BLogic-Microelectronic/BLogic-MCU/asic/reports/routing/wire_lengths.csv

net | length_um
i_soc.i_cpu.core_i.id_stage_i.regfile_addr_rc_id\[1\] | 7.905335mm
i_soc.i_cpu.core_i.id_stage_i.regfile_addr_rc_id\[0\] | 6.897295mm
i_soc.i_cpu.core_i.id_stage_i.regfile_addr_rc_id\[2\] | 4.46121mm
net1894 | 4.13363mm
net1641 | 4.11913mm
net1624 | 3.90591mm
net1005 | 3.87298mm
net1895 | 3.86943mm
net987 | 3.84854mm
net1642 | 3.7976mm
i_soc.i_cpu.core_i.id_stage_i.register_file_i._1001_ | 3.71167mm
net641 | 3.5976mm
net988 | 3.57505mm
net1356 | 3.54232mm
net1006 | 3.51843mm
net1362 | 3.41506mm
net1023 | 3.400835mm
net1317 | 3.39428mm
net1623 | 3.39394mm
net1299 | 3.391395mm
net1335 | 3.388515mm
net1357 | 3.37431mm
net781 | 3.34893mm
net780 | 3.33756mm
net1352 | 3.29609mm
net770 | 3.29593mm
net1300 | 3.26414mm
net1024 | 3.26218mm
net1342 | 3.2589mm
net790 | 3.25837mm
net775 | 3.248905mm
net1318 | 3.246175mm
net1347 | 3.24044mm
net1336 | 3.23486mm
net773 | 3.22972mm
net776 | 3.20083mm
net1337 | 3.18531mm
net795 | 3.17406mm
net800 | 3.15847mm
net771 | 3.15771mm
net1372 | 3.1337mm
net772 | 3.07681mm
net632 | 3.06338mm
i_soc.data_sram_bus.w_data\[11\] | 3.05232mm
net1377 | 3.0516mm
net785 | 3.05074mm
net1345 | 3.04885mm
i_soc.data_sram_bus.w_data\[15\] | 3.04538mm
i_soc.data_sram_bus.w_data\[10\] | 3.03835mm
net805 | 3.03568mm
net1387 | 3.03007mm
net1367 | 3.02305mm
i_soc.i_crossbar.instr_sram_mst.w_data\[23\] | 3.01788mm
net637 | 3.01578mm
i_soc.data_sram_bus.w_data\[8\] | 2.99364mm
net778 | 2.97687mm
net788 | 2.969405mm
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
net704 | 930.14µm
i_soc.i_instr_sram.u_sram.dout\[25\] | 930.01µm
i_soc.i_ai_accel._04530_ | 929.68µm
net4081 | 928.73µm
i_soc.cpu_data_bus.w_data\[23\] | 928.375µm
i_soc.i_axi_lite_bridge.m_araddr\[0\] | 927.02µm
net4087 | 927.01µm
i_soc.i_cpu.core_i.cs_registers_i._0949_ | 926.265µm
i_soc.ai_sram_bus.w_data\[17\] | 925.92µm
i_soc.i_ai_accel.state\[20\] | 924.76µm
i_soc.i_ai_sram.u_sram._315_ | 924.72µm
i_soc.i_instr_sram.u_sram.dout\[27\] | 924.14µm
net4102 | 922.7µm
i_soc.i_instr_sram.u_sram.dout\[6\] | 921.46µm
net4116 | 920.995µm
i_soc.i_data_sram.u_sram.dout\[39\] | 920.64µm
i_soc.cpu_data_bus.w_data\[16\] | 919.82µm
i_soc.cpu_data_bus.aw_addr\[11\] | 919.805µm
net4080 | 916.845µm
net687 | 915.98µm
i_soc.cpu_data_bus.w_data\[22\] | 915.12µm
i_soc.cpu_data_bus.w_data\[21\] | 913.74µm
net715 | 913.51µm
i_soc.i_uart_0._258_ | 912.595µm
net1212 | 911.97µm
i_soc.cpu_data_bus.w_data\[20\] | 911.61µm
i_soc.i_cpu.core_i.ex_stage_i.mult_i.op_b_i\[12\] | 911.13µm
i_soc.ai_sram_bus.w_data\[27\] | 910.22µm
i_soc.i_ai_sram.u_sram.gen_bank\[3\].csb0 | 910.03µm
i_soc.i_cpu.core_i.ex_stage_i.mult_i.op_b_i\[17\] | 909.98µm
net7548 | 909.22µm
i_soc.i_data_sram.u_sram.dout\[38\] | 908.07µm
i_soc.i_instr_sram.u_sram.gen_bank\[0\].csb1 | 907.24µm
i_soc.i_crossbar.instr_sram_mst.r_data\[8\] | 906.56µm
i_soc.i_ai_sram.u_sram._325_ | 905.345µm
i_soc.i_cpu.core_i.ex_stage_i.mult_i.op_b_i\[16\] | 904.44µm
net8659 | 904.295µm
i_soc.i_axi_lite_bridge.m_wdata\[14\] | 904.23µm
i_soc.cpu_data_bus.aw_addr\[12\] | 904.12µm
i_soc.cpu_data_bus.w_strb\[3\] | 903.97µm
i_soc.i_axi_lite_bridge.m_araddr\[1\] | 903.59µm
net1934 | 901.7µm
i_soc.i_qspi._07408_ | 900.295µm
i_soc.i_ai_accel._04545_ | 899.96µm
i_soc.i_crossbar.instr_sram_mst.r_data\[16\] | 899.8µm
net8688 | 899.35µm
i_soc.i_qspi._07425_ | 899.145µm
i_soc.i_instr_sram.u_sram.dout\[5\] | 897.23µm
i_soc.i_cpu.core_i.cs_registers_i.csr_save_ex_i | 894.42µm
net8658 | 894.415µm
i_soc.i_ai_sram.u_sram._035_ | 893.8µm
i_soc.i_cpu.core_i.ex_stage_i.mult_i.op_b_i\[13\] | 893.045µm
net4096 | 892.92µm
i_soc.i_instr_sram.u_sram.dout\[26\] | 892.64µm
i_soc.i_ai_sram.u_sram.gen_bank\[11\].csb0 | 892.33µm
net20330 | 891.83µm
net8717 | 891.805µm
i_soc.i_ai_accel.co_raddr\[9\] | 891.385µm
net4118 | 890.965µm
i_soc.i_ai_sram.u_sram._045_ | 890.88µm
net4078 | 890.44µm
i_soc.i_cpu.core_i.alu_operand_b_ex\[31\] | 889.115µm
i_soc.i_ai_accel._09532_ | 888.86µm
net8662 | 888.18µm
net4101 | 887.895µm
i_soc.i_cpu.core_i.ex_stage_i.mult_dot_op_c_i\[16\] | 887.695µm
i_soc.i_ai_sram.u_sram._335_ | 886.595µm
net20164 | 886.45µm
net8661 | 885.84µm
net4082 | 884.96µm
i_soc.i_cpu.core_i.ex_stage_i.mult_dot_op_c_i\[17\] | 883.74µm
i_soc.i_cpu.core_i.ex_stage_i.mult_dot_op_c_i\[5\] | 883.72µm
net4076 | 882.95µm
net3303 | 882.74µm
net3025 | 882.05µm
i_soc.i_cpu.core_i.ex_stage_i.mult_dot_op_c_i\[19\] | 881.21µm
net4110 | 881.16µm
i_soc.i_cpu.core_i.ex_stage_i.alu_i._1383_ | 881.09µm
clknet_6_4__leaf_clk_i_regs | 880.98µm
net8713 | 877.745µm
i_soc.i_ai_sram.u_sram._031_ | 877.66µm
net9087 | 877.1µm
i_soc.i_ai_accel._04533_ | 876.18µm
net4089 | 875.85µm
net3865 | 874.29µm
i_soc.i_ai_accel._09771_ | 874.14µm
i_soc.i_cpu.core_i.alu_operand_b_ex\[30\] | 872.05µm
i_soc.i_ai_accel.u_conv_out.gen_bank\[0\].csb1 | 870.31µm
i_soc.i_cpu.core_i.alu_operand_b_ex\[21\] | 870.05µm
i_soc.i_ai_sram.u_sram._018_ | 867.72µm
i_soc.i_cpu.core_i.ex_stage_i.mult_i.op_b_i\[14\] | 867.605µm
net8672 | 867.53µm
net4124 | 866.86µm
i_soc.i_cpu.core_i.ex_stage_i.mult_dot_op_c_i\[4\] | 866.685µm
i_soc.i_ai_sram.u_sram._016_ | 866.44µm
net8645 | 865.58µm
i_soc.i_ai_accel._04532_ | 865.49µm
i_soc.i_cpu.core_i.ex_stage_i.mult_i.op_b_i\[10\] | 864.83µm
net8644 | 864.2µm
i_soc.i_ai_accel._04650_ | 863.915µm
i_soc.i_cpu.core_i.ex_stage_i.mult_i.multicycle_o | 862.44µm
i_soc.i_crossbar.instr_sram_mst.r_data\[15\] | 861.34µm
i_soc.i_crossbar.instr_sram_mst.r_data\[13\] | 860µm
clknet_6_15__leaf_clk_i_regs | 859.805µm
net10603 | 859.7µm
net8646 | 858.03µm
i_soc.i_ai_sram.u_sram._332_ | 857.76µm
i_soc.i_qspi._07593_ | 857.44µm
net3971 | 854.88µm
net26 | 853.16µm
i_soc.i_cpu.core_i.ex_stage_i.mult_i.op_b_i\[15\] | 851.445µm
net8660 | 850.06µm
i_soc.i_ai_accel._05126_ | 849.675µm
net8674 | 849.46µm
i_soc.i_cpu.core_i.ex_stage_i.mult_dot_op_b_i\[26\] | 849.08µm
i_soc.i_ai_sram.u_sram._028_ | 847.96µm
net4077 | 847.425µm
i_soc.i_cpu.core_i.alu_operand_c_ex\[13\] | 846.745µm
i_soc.i_qspi.cmd_tx_data\[29\] | 846.51µm
i_soc.i_cpu.core_i.alu_operand_b_ex\[3\] | 846.435µm
i_soc.i_axi_lite_bridge.m_araddr\[2\] | 845.82µm
i_soc.i_cpu.core_i.id_stage_i.register_file_i._1004_ | 845.285µm
i_soc.i_ai_sram.u_sram._052_ | 843.215µm
i_soc.i_ai_accel.state\[24\] | 842.89µm
i_soc.i_ai_accel._09778_ | 842.18µm
i_soc.i_ai_accel._04357_ | 842.055µm
net3219 | 841.135µm
i_soc.i_cpu.core_i.ex_stage_i.mult_dot_op_c_i\[30\] | 840.04µm
i_soc.i_cpu.core_i.ex_stage_i.mult_dot_op_c_i\[25\] | 839.26µm
i_soc.i_ai_sram.u_sram._342_ | 838.32µm
i_soc.i_cpu.core_i.ex_stage_i.mult_i.op_b_i\[24\] | 837.68µm
net669 | 837.08µm
net3974 | 836.685µm
i_soc.i_qspi.cmd_tx_data\[22\] | 836.1µm
i_soc.dmi_req\[30\] | 835.915µm
i_soc.i_ai_accel._09799_ | 835.48µm
net3961 | 835.21µm
i_soc.i_cpu.core_i.alu_operand_b_ex\[29\] | 834.475µm
clknet_2_3_1_clk_i | 834.28µm
i_soc.i_cpu.core_i.id_stage_i.regfile_addr_rc_id\[5\] | 833.405µm
i_soc.i_cpu.core_i.ex_stage_i.mult_dot_op_c_i\[18\] | 832.55µm
net3862 | 830.235µm
i_soc.i_cpu.core_i.id_stage_i.decoder_i.instr_rdata_i\[22\] | 829.57µm
i_soc.i_qspi.rx_rd_ptr\[5\] | 829.46µm
i_soc.i_ai_sram.u_sram._027_ | 828.96µm
i_soc.i_cpu.core_i.ex_stage_i.mult_dot_op_c_i\[24\] | 828.3µm
i_soc.i_ai_accel._05334_ | 825.06µm
i_soc.i_ai_accel._09764_ | 824.78µm
i_soc.i_ai_sram.u_sram.gen_bank\[7\].csb1 | 823.38µm
net4108 | 820.52µm
net674 | 819.935µm
i_soc.i_ai_sram.u_sram._042_ | 819.14µm
i_soc.i_crossbar.instr_sram_mst.aw_addr\[8\] | 818.9µm
i_soc.i_cpu.core_i.ex_stage_i.mult_dot_op_a_i\[8\] | 818.74µm
i_soc.i_cpu.core_i.ex_stage_i.mult_dot_op_b_i\[11\] | 818.735µm
i_soc.cpu_data_bus.w_strb\[2\] | 818.6µm
net725 | 817.68µm
net20266 | 816.72µm
net4105 | 816.22µm
i_soc.i_ai_accel._09785_ | 814.22µm
clknet_6_29__leaf_clk_i_regs | 814.04µm
i_soc.i_i2c._0308_ | 810.24µm
net384 | 809.87µm
i_soc.i_ai_accel._09792_ | 809.69µm
i_soc.i_ai_accel._04543_ | 808.99µm
i_soc.i_cpu.core_i.ex_stage_i.mult_dot_op_c_i\[21\] | 808.07µm
i_soc.i_ai_accel._09756_ | 806.6µm
i_soc.i_ai_accel._04506_ | 806.26µm
net2403 | 806.15µm
i_soc.i_cpu.core_i.cs_registers_i.pc_id_i\[2\] | 803.625µm
net21044 | 803.45µm
net8654 | 803.3µm
i_soc.i_cpu.core_i.ex_stage_i.mult_dot_op_b_i\[21\] | 802.98µm
i_soc.i_cpu.core_i.ex_stage_i.mult_i._04884_ | 802.88µm
i_soc.i_cpu.core_i.ex_stage_i.mult_dot_op_b_i\[22\] | 802.82µm
i_soc.i_ai_accel._04358_ | 801.73µm
i_soc.i_crossbar.instr_sram_mst.aw_addr\[10\] | 800.9µm
net2362 | 800.5µm
net3023 | 800.03µm
net20492 | 799.64µm
clknet_6_5__leaf_clk_i_regs | 798.28µm
net3324 | 798.1µm
i_soc.i_instr_sram._10_ | 797.87µm
net3768 | 797.08µm
i_soc.i_cpu.core_i.id_stage_i._1319_ | 796.88µm
i_soc.i_ai_sram.u_sram.gen_bank\[0\].csb0 | 795.98µm
net3337 | 795.66µm
clknet_6_11__leaf_clk_i_regs | 794.76µm
i_soc.i_qspi.cmd_tx_data\[10\] | 794.15µm
i_soc.cpu_data_bus.w_data\[26\] | 793.54µm
i_soc.i_ai_accel._05092_ | 793.325µm
i_soc.i_cpu.core_i.alu_operand_a_ex\[17\] | 793.14µm
net3359 | 792.64µm
net2363 | 792.635µm
i_soc.i_crossbar.instr_sram_mst.aw_addr\[9\] | 792.2µm
i_soc.i_cpu.core_i.alu_vec_mode_ex\[0\] | 791.065µm
clknet_2_0_1_clk_i | 790.7µm
i_soc.i_ai_sram.u_sram._014_ | 789.36µm
i_soc.i_cpu.core_i.alu_operand_c_ex\[20\] | 788.88µm
net18623 | 786.76µm
i_soc.i_cpu.core_i.alu_operand_c_ex\[22\] | 786.665µm
net8652 | 784.84µm
net8650 | 783.48µm
i_soc.i_crossbar.instr_sram_mst.aw_addr\[6\] | 782.04µm
net2994 | 781.925µm
net20184 | 781.86µm
i_soc.i_ai_accel._09806_ | 781.58µm
i_soc.i_cpu.core_i.id_stage_i._1463_ | 780.45µm
i_soc.i_cpu.core_i.ex_stage_i.mult_dot_op_b_i\[12\] | 780.31µm
i_soc.i_cpu.core_i.id_stage_i.register_file_i._3519_ | 779.025µm
i_soc.i_cpu.core_i.ex_stage_i.mult_dot_op_c_i\[3\] | 778.935µm
net3962 | 778.64µm
net8668 | 778.24µm
net4079 | 777.81µm
net21127 | 777.18µm
i_soc.dmi_req\[34\] | 776.13µm
net735 | 775.4µm
i_soc.i_qspi._05675_ | 775.015µm
net8716 | 774.66µm
i_soc.cpu_data_bus.w_strb\[1\] | 774.37µm
net16923 | 773.68µm
i_soc.i_cpu.core_i.alu_operand_c_ex\[9\] | 773.17µm
i_soc.i_qspi.cmd_tx_data\[28\] | 772.99µm
i_soc.i_cpu.core_i.ex_stage_i.mult_en_i | 771.91µm
i_soc.i_ai_accel.co_rdata\[27\] | 770.98µm
net3969 | 769.555µm
net10701 | 769.2µm
net4123 | 768.7µm
i_soc.i_cpu.core_i.alu_operand_c_ex\[15\] | 768.615µm
i_soc.dmi_req\[16\] | 767.28µm
clknet_0_i_soc.i_cpu.core_i.clk | 766.735µm
net3966 | 766.36µm
i_soc.i_cpu.core_i.if_stage_i._087_ | 766.245µm
i_soc.i_crossbar.instr_sram_mst.aw_addr\[7\] | 765.96µm
net3979 | 764.655µm
net18170 | 764.6µm
i_soc.i_cpu.core_i.if_stage_i._088_ | 764.26µm
i_soc.i_crossbar.instr_sram_mst.r_data\[26\] | 764.25µm
i_soc.i_cpu.core_i.ex_stage_i.mult_dot_op_c_i\[26\] | 764.22µm
i_soc.i_axi_lite_bridge.m_wdata\[16\] | 763.9µm
i_soc.i_cpu.core_i.ex_stage_i.mult_dot_op_c_i\[28\] | 763.14µm
i_soc.i_cpu.core_i.ex_stage_i.mult_dot_op_a_i\[23\] | 760.22µm
i_soc.i_cpu.core_i.ex_stage_i.mult_dot_op_b_i\[19\] | 759.995µm
net3858 | 759.6µm
net285 | 758.46µm
i_soc.i_axi_lite_bridge.m_wdata\[19\] | 758.44µm
i_soc.i_cpu.core_i.cs_registers_i.pc_id_i\[8\] | 757.595µm
i_soc.i_ai_accel._05219_ | 757.14µm
i_soc.i_cpu.core_i.cs_registers_i._1159_ | 755.49µm
net3866 | 755.34µm
i_soc.i_cpu.core_i.id_stage_i._0939_ | 754.93µm
i_soc.i_ai_accel.state\[12\] | 754µm
i_soc.i_cpu.core_i.ex_stage_i.mult_dot_op_c_i\[20\] | 753.94µm
i_soc.i_cpu.core_i.ex_stage_i.mult_dot_op_c_i\[31\] | 753.29µm
i_soc.i_cpu.core_i.id_stage_i._1473_ | 752.78µm
net70 | 751.74µm
i_soc.i_cpu.core_i.alu_operand_c_ex\[10\] | 751.54µm
i_soc.i_qspi.cmd_tx_data\[27\] | 751.475µm
i_soc.i_crossbar.instr_sram_mst.r_data\[24\] | 750.76µm
i_soc.i_cpu.core_i.ex_stage_i.mult_dot_op_c_i\[23\] | 750.69µm
i_soc.i_ai_accel.co_wdata\[0\] | 750.64µm
i_soc.i_cpu.core_i.ex_stage_i.mult_dot_op_b_i\[13\] | 750.11µm
i_soc.i_ai_accel.co_wdata\[14\] | 749.88µm
i_soc.cpu_instr_bus.ar_addr\[12\] | 749.34µm
net2476 | 748.95µm
i_soc.i_crossbar.instr_sram_mst.r_data\[29\] | 748.65µm
net2732 | 748.52µm
i_soc.i_crossbar.instr_sram_mst.aw_addr\[4\] | 748.5µm
delaynet_13_clk | 748.49µm
i_soc.dmi_req\[28\] | 746.32µm
i_soc.i_cpu.core_i.ex_stage_i.mult_dot_op_c_i\[22\] | 745.78µm
i_soc.i_cpu.core_i.ex_stage_i.mult_i.result_o\[11\] | 745.64µm
i_soc.dmi_req\[20\] | 745.6µm
i_soc.i_cpu.core_i.alu_operand_c_ex\[31\] | 745.54µm
net4170 | 745.5µm
i_soc.i_qspi.cmd_tx_data\[13\] | 744.9µm
clknet_6_28__leaf_clk_i_regs | 744.32µm
i_soc.i_crossbar.instr_sram_mst.r_data\[25\] | 743.66µm
i_soc.i_ai_accel.co_wdata\[13\] | 743.52µm
i_soc.i_crossbar.instr_sram_mst.r_data\[27\] | 743.44µm
i_soc.i_cpu.core_i.id_stage_i._1300_ | 742.505µm
net2181 | 742.09µm
i_soc.i_cpu.core_i.alu_is_clpx_ex | 741.625µm
i_soc.i_qspi._07413_ | 740.83µm
i_soc.i_cpu.core_i.ex_stage_i.mult_i.result_o\[7\] | 740.82µm
i_soc.i_cpu.core_i.cs_registers_i.debug_mode_i | 740.815µm
i_soc.i_crossbar.instr_sram_mst.aw_addr\[5\] | 739.56µm
net4171 | 738.875µm
i_soc.i_crossbar.instr_sram_mst.r_data\[22\] | 738.82µm
net2352 | 737.15µm
net4109 | 737.05µm
net4161 | 736.835µm
net4176 | 736.56µm
i_soc.cpu_instr_bus.ar_addr\[11\] | 736.37µm
i_soc.i_cpu.core_i.alu_operand_c_ex\[4\] | 735.9µm
net18153 | 735.89µm
clknet_0_clk_i_regs | 735.595µm
i_soc.i_cpu.core_i.alu_operand_a_ex\[16\] | 735.515µm
i_soc.i_cpu.core_i.alu_operand_a_ex\[12\] | 734.935µm
i_soc.i_cpu.core_i.alu_operand_c_ex\[11\] | 734.495µm
net20155 | 733.85µm
net2359 | 733.32µm
i_soc.i_cpu.core_i.id_stage_i.decoder_i.instr_rdata_i\[19\] | 732.79µm
i_soc.i_cpu.core_i.ex_stage_i.mult_dot_op_b_i\[28\] | 732.44µm
net714 | 731.48µm
net20200 | 730.61µm
i_soc.i_qspi.cmd_tx_data\[16\] | 730.18µm
clknet_2_2_1_clk_i | 729.97µm
i_soc.i_ai_accel._04508_ | 729.72µm
net3984 | 729.53µm
i_soc.i_cpu.core_i.ex_stage_i.mult_dot_op_b_i\[29\] | 729.44µm
i_soc.i_crossbar.instr_sram_mst.r_data\[30\] | 729.37µm
i_soc.i_cpu.core_i.ex_stage_i.mult_i.ready_o | 728.4µm
net4165 | 728.095µm
net736 | 726.13µm
i_soc.i_cpu.core_i.cs_registers_i.pc_id_i\[1\] | 725.79µm
net10699 | 725.62µm
net650 | 725.535µm
net8693 | 725.22µm
i_soc.i_cpu.core_i.ex_stage_i.mult_dot_op_c_i\[29\] | 724.28µm
i_soc.i_cpu.core_i.ex_stage_i.mult_dot_op_b_i\[10\] | 724.27µm
net4175 | 723.995µm
i_soc.i_cpu.core_i.ex_stage_i.mult_i.result_o\[8\] | 723.56µm
clknet_6_45__leaf_clk_i_regs | 722.27µm
net4162 | 722.06µm
i_soc.i_axi_lite_bridge.m_wdata\[17\] | 721.94µm
clknet_6_6__leaf_clk_i_regs | 721.9µm
i_soc.i_cpu.core_i.id_stage_i._1440_ | 721.58µm
net4056 | 721.535µm
net730 | 720.42µm
i_soc.i_cpu.core_i.ex_stage_i.mult_i.result_o\[19\] | 720.21µm
net4242 | 719.46µm
net4156 | 719.44µm
i_soc.i_dm_top.i_dm_csrs._0540_ | 719.315µm
i_soc.i_axi_lite_bridge.m_wdata\[15\] | 719.26µm
net8670 | 718.7µm
i_soc.i_cpu.core_i.cs_registers_i.pc_id_i\[3\] | 718.41µm
i_soc.i_cpu.core_i.ex_stage_i.mult_dot_op_c_i\[14\] | 718.19µm
i_soc.i_crossbar.instr_sram_mst.r_data\[31\] | 718.13µm
i_soc.i_cpu.core_i.ex_stage_i.mult_i.op_b_i\[25\] | 717.85µm
net4174 | 717.28µm
net4181 | 717.07µm
net3859 | 716.86µm
i_soc.i_cpu.core_i.ex_stage_i.mult_dot_op_c_i\[11\] | 716.655µm
net4172 | 716.6µm
i_soc.i_cpu.core_i.cs_registers_i.pc_id_i\[10\] | 716.49µm
net8679 | 715.94µm
i_soc.i_cpu.core_i.ex_stage_i.mult_dot_op_a_i\[7\] | 715.41µm
net4097 | 714.98µm
net4244 | 714.65µm
i_soc.i_crossbar.instr_sram_mst.r_data\[23\] | 713.84µm
i_soc.i_cpu.core_i.alu_operand_c_ex\[23\] | 713.76µm
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
i_soc.i_cpu.core_i.alu_operand_b_ex\[17\] | 680.51µm
net4199 | 680.255µm
net4235 | 680.175µm
net2189 | 679.98µm
net4180 | 679.93µm
net4231 | 679.58µm
i_soc.i_ai_accel._05130_ | 678.86µm
i_soc.i_ai_accel._04349_ | 678.78µm
i_soc.i_dm_top.i_dm_mem._0425_ | 678.535µm
net4239 | 678.415µm
net4202 | 678.205µm
net4245 | 678.165µm
net4189 | 677.045µm
net4201 | 676.925µm
clknet_6_18__leaf_clk_i_regs | 676.86µm
net3009 | 676.59µm
i_soc.cpu_data_bus.ar_addr\[9\] | 676.38µm
net4197 | 676.27µm
i_soc.i_cpu.core_i.cs_registers_i._1028_ | 676.12µm
i_soc.i_cpu.core_i.bmask_a_ex\[1\] | 674.335µm
net4246 | 672.945µm
net4107 | 672.92µm
net2347 | 672.52µm
net4248 | 672.46µm
i_soc.i_qspi._00010_ | 671.32µm
net729 | 671.025µm
i_soc.i_qspi._00014_ | 670.76µm
net2358 | 670.315µm
i_soc.i_ai_accel.co_rdata\[26\] | 670.04µm
net724 | 669.6µm
i_soc.i_cpu.core_i.ex_stage_i.mult_dot_op_a_i\[14\] | 669.575µm
net20967 | 669.38µm
net4237 | 669.14µm
i_soc.i_ai_accel._10353_ | 669µm
i_soc.i_cpu.core_i.ex_stage_i.mult_i.op_c_i\[21\] | 668.82µm
i_soc.i_cpu.core_i.ex_stage_i.mult_i.result_o\[2\] | 668.72µm
i_soc.i_cpu.core_i.id_stage_i.decoder_i.instr_rdata_i\[31\] | 668.505µm
net4234 | 668.435µm
net4992 | 668.16µm
i_soc.dmi_req\[21\] | 667.605µm
net4251 | 667.265µm
net21132 | 667.04µm
net3342 | 666.34µm
i_soc.i_cpu.core_i.ex_stage_i.mult_i.result_o\[1\] | 665.04µm
i_soc.i_cpu.core_i.id_stage_i._1452_ | 664.9µm
i_soc.i_cpu.core_i.alu_operand_a_ex\[8\] | 664.79µm
i_soc.i_cpu.core_i.ex_stage_i.mult_dot_op_c_i\[6\] | 664.55µm
i_soc.i_cpu.core_i.ex_stage_i.mult_i.result_o\[26\] | 664.45µm
net4254 | 663.975µm
i_soc.i_cpu.core_i.cs_registers_i.pc_id_i\[0\] | 663.16µm
delaynet_14_clk | 663.14µm
net3986 | 662.85µm
net4086 | 661.765µm
clknet_6_53__leaf_clk_i_regs | 661.1µm
i_soc.i_ai_accel.cw_raddr\[2\] | 660.98µm
i_soc.i_cpu.core_i.if_stage_i.aligner_i._137_ | 660.675µm
i_soc.i_cpu.core_i.id_stage_i._1312_ | 660.33µm
i_soc.i_cpu.core_i.ex_stage_i.mult_dot_op_c_i\[9\] | 659.78µm
net3343 | 659.505µm
net2501 | 659.43µm
clknet_leaf_15_clk_i | 659.25µm
i_soc.i_cpu.core_i.alu_operand_b_ex\[10\] | 658.44µm
i_soc.i_dm_top.cmdbusy | 658.21µm
i_soc.i_cpu.core_i.ex_stage_i.mult_dot_op_b_i\[27\] | 658.14µm
net9278 | 658.02µm
i_soc.i_cpu.core_i.ex_stage_i.mult_i.op_c_i\[23\] | 657.09µm
net2186 | 656.75µm
delaynet_31_clk | 656.62µm
i_soc.i_cpu.core_i.ex_stage_i.mult_i.result_o\[25\] | 656.38µm
net968 | 655.905µm
net4240 | 654.905µm
net8676 | 654.44µm
net4253 | 653.695µm
i_soc.i_cpu.core_i.id_stage_i._1193_ | 653.38µm
clknet_6_57__leaf_clk_i_regs | 653.22µm
i_soc.i_cpu.core_i.id_stage_i._1164_ | 652.72µm
i_soc.i_cpu.core_i.id_stage_i.register_file_i._0997_ | 652.46µm
i_soc.i_cpu.core_i.ex_stage_i.mult_i.result_o\[24\] | 652.37µm
i_soc.i_ai_accel.co_rdata\[29\] | 652.02µm
i_soc.i_cpu.core_i.alu_operand_a_ex\[3\] | 651.985µm
net1775 | 651.685µm
i_soc.i_uart_0._179_ | 651.6µm
i_soc.i_cpu.core_i.alu_operand_c_ex\[30\] | 651.57µm
net3983 | 650.98µm
net678 | 650.86µm
i_soc.i_cpu.core_i.alu_operand_c_ex\[27\] | 650.58µm
net21079 | 650.51µm
i_soc.i_ai_accel._10676_ | 650.465µm
clknet_leaf_8_clk_i | 650.3µm
i_soc.i_cpu.core_i.cs_registers_i.pc_id_i\[5\] | 649.98µm
i_soc.i_qspi._07597_ | 649.94µm
i_soc.i_cpu.core_i.id_stage_i._1065_ | 649.41µm
i_soc.i_cpu.core_i.if_stage_i.prefetch_buffer_i.prefetch_controller_i._039_ | 649.11µm
i_soc.i_cpu.core_i.alu_operand_c_ex\[16\] | 648.705µm
i_soc.i_cpu.core_i.id_stage_i.register_file_i._3876_ | 648.14µm
clknet_leaf_13_clk_i | 646.805µm
net3963 | 646.58µm
i_soc.i_cpu.core_i.alu_operand_c_ex\[2\] | 646.175µm
net20495 | 645.89µm
net2357 | 645.785µm
i_soc.i_cpu.core_i.alu_operand_a_ex\[18\] | 645.75µm
i_soc.i_qspi._05466_ | 644.28µm
i_soc.i_cpu.core_i.ex_stage_i.mult_dot_op_b_i\[3\] | 643.58µm
clknet_6_9__leaf_clk_i_regs | 643.02µm
i_soc.cpu_data_bus.ar_addr\[10\] | 642.85µm
net4113 | 642.77µm
i_soc.i_dm_top.i_dm_mem._0410_ | 642.71µm
i_soc.i_cpu.core_i.ex_stage_i.mult_dot_op_b_i\[5\] | 642.24µm
i_soc.i_ai_accel.cw_raddr\[3\] | 641.895µm
clknet_6_55__leaf_clk_i_regs | 641.84µm
net4099 | 641.835µm
net3981 | 641.78µm
net3022 | 641.72µm
net960 | 641.59µm
net8673 | 641.54µm
i_soc.i_cpu.core_i.ex_stage_i.mult_dot_op_b_i\[18\] | 641.155µm
net2185 | 641.14µm
i_soc.i_cpu.core_i.id_stage_i._1468_ | 641.07µm
i_soc.i_cpu.core_i.ex_stage_i.mult_i._04394_ | 640.965µm
net4092 | 640.64µm
net69 | 640.16µm
i_soc.i_cpu.core_i.ex_stage_i.mult_i._04363_ | 640.15µm
i_soc.i_axi_lite_bridge.m_wdata\[18\] | 639.58µm
net4085 | 639.555µm
net21226 | 639.25µm
i_soc.i_cpu.core_i.id_stage_i._1174_ | 638.92µm
i_soc.i_qspi.cmd_tx_data\[26\] | 638.7µm
i_soc.i_cpu.core_i.id_stage_i.register_file_i._3165_ | 637.995µm
net21219 | 637.94µm
i_soc.i_cpu.core_i.alu_operand_c_ex\[7\] | 637.86µm
i_soc.i_cpu.core_i.ex_stage_i.mult_i._06683_ | 637.82µm
net3975 | 636.17µm
i_soc.i_cpu.core_i.id_stage_i.register_file_i._3091_ | 636.16µm
i_soc.i_cpu.core_i.ex_stage_i.mult_i.result_o\[9\] | 636.04µm
i_soc.i_cpu.core_i.bmask_a_ex\[0\] | 635.855µm
net9137 | 634.95µm
clknet_6_21__leaf_clk_i_regs | 634.44µm
clknet_5_18__leaf_i_soc.i_cpu.core_i.clk | 634.335µm
net3537 | 634.18µm
net2715 | 634.16µm
net2180 | 634.02µm
net625 | 633.74µm
i_soc.i_cpu.core_i.ex_stage_i.mult_dot_op_a_i\[5\] | 633.03µm
i_soc.i_qspi._05429_ | 632.72µm
i_soc.i_cpu.core_i.ex_stage_i.mult_i._06687_ | 631.795µm
i_soc.i_ai_accel.state\[9\] | 631.72µm
net319 | 631.68µm
net7764 | 631.52µm
net2188 | 631.47µm
i_soc.i_ai_accel._04362_ | 631.13µm
i_soc.i_cpu.core_i.ex_stage_i.mult_dot_op_a_i\[15\] | 630.83µm
net2697 | 630.77µm
i_soc.i_cpu.core_i.cs_registers_i.pc_id_i\[11\] | 630.23µm
net20207 | 630.22µm
net2680 | 629.73µm
i_soc.i_crossbar._0194_ | 629.09µm
clknet_leaf_31_clk_i | 629.03µm
i_soc.i_cpu.core_i.ex_stage_i.mult_dot_op_c_i\[8\] | 628.93µm
i_soc.i_cpu.core_i.ex_stage_i.mult_i.op_b_i\[26\] | 628.62µm
i_soc.i_cpu.core_i.ex_stage_i.mult_dot_op_b_i\[16\] | 628.57µm
net723 | 628.51µm
net4389 | 628.36µm
clknet_leaf_10_clk_i | 628.2µm
i_soc.i_cpu.core_i.id_stage_i.register_file_i._3016_ | 627.34µm
net9171 | 627.13µm
net21298 | 627.04µm
net1764 | 626.635µm
net3386 | 626.55µm
clknet_5_3__leaf_i_soc.i_cpu.core_i.clk | 626.48µm
i_soc.i_cpu.core_i.id_stage_i.decoder_i.mult_signed_mode_o\[1\] | 626.25µm
i_soc.i_cpu.core_i.id_stage_i._1495_ | 626.18µm
i_soc.i_cpu.core_i.alu_operand_a_ex\[19\] | 626.14µm
net4568 | 625.67µm
i_soc.i_cpu.core_i.ex_stage_i.alu_i.alu_div_i.InVld_SI | 625.11µm
net2364 | 625.05µm
net8666 | 624.78µm
net20226 | 624.55µm
net20494 | 624.11µm
i_soc.i_cpu.core_i.ex_stage_i.mult_i.op_c_i\[24\] | 623.8µm
clknet_2_0_0_clk_i | 623.78µm
i_soc.i_cpu.core_i.ex_stage_i.mult_i.op_c_i\[25\] | 623.76µm
i_soc.i_cpu.core_i.alu_operand_b_ex\[18\] | 623.28µm
i_soc.i_cpu.core_i.alu_operand_c_ex\[18\] | 623.115µm
net2731 | 623µm
net8675 | 622.84µm
i_soc.i_cpu.core_i.id_stage_i.is_compressed_i | 622.32µm
i_soc.i_qspi._05427_ | 622.26µm
i_soc.i_cpu.core_i.id_stage_i.register_file_i._3341_ | 622.125µm
clknet_6_14__leaf_clk_i_regs | 621.895µm
clknet_6_3__leaf_clk_i_regs | 621.68µm
i_soc.i_cpu.core_i.cs_registers_i.pc_id_i\[9\] | 621.45µm
net689 | 621.34µm
i_soc.i_ai_accel.cur_wb\[0\] | 620.94µm
net8801 | 620.74µm
net1776 | 620.575µm
i_soc.i_cpu.core_i.ex_stage_i.mult_i._04400_ | 620.5µm
i_soc.i_cpu.core_i.id_stage_i.decoder_i.mult_operator_o\[1\] | 620.14µm
i_soc.i_cpu.core_i.ex_stage_i.mult_dot_op_c_i\[13\] | 620.085µm
clknet_6_23__leaf_clk_i_regs | 619.935µm
net3554 | 619.91µm
i_soc.i_cpu.core_i.id_stage_i._1155_ | 619.79µm
net4314 | 619.78µm
i_soc.i_cpu.core_i.id_stage_i._1478_ | 619.67µm
net2368 | 619.53µm
clknet_leaf_3_clk_i | 619.4µm
i_soc.i_cpu.core_i.alu_operand_c_ex\[12\] | 618.645µm
i_soc.i_ai_accel._04716_ | 618.38µm
net20743 | 618.14µm
i_soc.i_ai_accel._10336_ | 618.12µm
i_soc.i_cpu.core_i.id_stage_i._1125_ | 618.04µm
net2507 | 618.04µm
net731 | 617.88µm
i_soc.i_cpu.core_i.alu_operand_c_ex\[5\] | 617.835µm
i_soc.i_cpu.core_i.id_stage_i.decoder_i.mult_signed_mode_o\[0\] | 617.56µm
net1716 | 617.3µm
net4388 | 617.07µm
net8651 | 617.06µm
clknet_6_32__leaf_clk_i_regs | 616.785µm
i_soc.i_qspi.cmd_tx_data\[21\] | 615.72µm
i_soc.i_qspi._05413_ | 615.52µm
net4265 | 615.16µm
net733 | 614.905µm
i_soc.i_cpu.core_i.id_stage_i.register_file_i._3308_ | 614.9µm
i_soc.i_cpu.core_i.alu_operand_c_ex\[1\] | 614.51µm
i_soc.i_uart_1._0593_ | 614.46µm
clknet_leaf_26_clk_i | 614.16µm
net1766 | 614.14µm
net8924 | 613.94µm
net4114 | 613.58µm
net711 | 613.15µm
i_soc.i_cpu.core_i.ex_stage_i.mult_i._04329_ | 612.585µm
clknet_leaf_24_clk_i | 612.1µm
i_soc.i_qspi._05433_ | 611.94µm
i_soc.cpu_data_bus.ar_addr\[5\] | 611.9µm
i_soc.i_dmi_jtag._053_ | 611.89µm
i_soc.i_cpu.core_i.ex_stage_i.mult_i._04324_ | 611.65µm
net20384 | 611.6µm
i_soc.i_cpu.core_i.ex_stage_i.mult_i.result_o\[28\] | 610.12µm
i_soc.i_cpu.core_i.alu_operand_b_ex\[2\] | 610.11µm
net8966 | 610.08µm
net20626 | 610.02µm
clknet_leaf_20_clk_i | 610.015µm
net3330 | 609.72µm
net21194 | 609.24µm
i_soc.i_cpu.core_i.id_stage_i.regfile_data_ra_id\[12\] | 609.14µm
i_soc.i_cpu.core_i.ex_stage_i.mult_i.result_o\[16\] | 609.02µm
net20388 | 608.26µm
i_soc.i_ai_accel._10317_ | 607.55µm
i_soc.dmi_req\[19\] | 607.065µm
i_soc.i_cpu.core_i.ex_stage_i.mult_i.op_c_i\[14\] | 605.94µm
net2472 | 605.9µm
clknet_6_10__leaf_clk_i_regs | 604.52µm
i_soc.i_cpu.core_i.id_stage_i.jump_target_o\[9\] | 604.28µm
clknet_2_1_0_clk_i | 603.98µm
net2803 | 603.94µm
net9161 | 603.66µm
net1701 | 603.235µm
i_soc.i_cpu.core_i.cs_registers_i.pc_id_i\[18\] | 602.81µm
i_soc.i_cpu.core_i.id_stage_i._1145_ | 602.63µm
net2996 | 602.59µm
net1715 | 602.57µm
i_soc.i_crossbar._0204_ | 602.5µm
i_soc.i_qspi._05411_ | 601.72µm
i_soc.ai_sram_bus.aw_addr\[13\] | 601.66µm
net3977 | 601.66µm
net680 | 601.65µm
net4283 | 601.59µm
i_soc.i_axi_lite_bridge.m_wdata\[20\] | 601µm
i_soc.i_periph_decoder._0078_ | 600.82µm
i_soc.i_cpu.core_i.id_stage_i.register_file_i._3483_ | 600.8µm
clknet_3_7_0_clk_i_regs | 600.635µm
net8689 | 600.43µm
i_soc.i_cpu.core_i.ex_stage_i.mult_i._11355_ | 599.97µm
i_soc.i_qspi.spi_state\[6\] | 599.59µm
net3574 | 599.17µm
i_soc.i_cpu.core_i.id_stage_i.register_file_i._0999_ | 598.75µm
net1707 | 598.08µm
i_soc.i_cpu.core_i.alu_operand_c_ex\[26\] | 597.18µm
i_soc.i_cpu.core_i.ex_stage_i.mult_i.result_o\[4\] | 597.16µm
net8687 | 596.59µm
i_soc.i_cpu.core_i.alu_operand_a_ex\[22\] | 596.42µm
net1760 | 596.22µm
i_soc.dmi_req\[5\] | 596.17µm
i_soc.i_cpu.core_i.alu_operand_a_ex\[20\] | 595.18µm
i_soc.i_ai_accel._10331_ | 594.82µm
net3864 | 594.675µm
i_soc.i_qspi._07426_ | 594.3µm
net321 | 594.255µm
i_soc.i_cpu.core_i.cs_registers_i.pc_id_i\[13\] | 594.155µm
i_soc.i_cpu.core_i.id_stage_i.register_file_i._3379_ | 594.145µm
net2918 | 594.03µm
i_soc.i_crossbar._0192_ | 593.96µm
i_soc.i_qspi._05461_ | 593.68µm
i_soc.i_cpu.core_i.cs_registers_i.pc_id_i\[12\] | 593.04µm
i_soc.i_cpu.core_i.ex_stage_i.alu_i.alu_div_i.OutVld_SO | 591.7µm
i_soc.i_ai_accel._04509_ | 591.53µm
net1703 | 591.335µm
net437 | 591.2µm
i_soc.i_cpu.core_i.cs_registers_i.pc_id_i\[15\] | 591.18µm
i_soc.dmi_req\[10\] | 591.105µm
i_soc.i_ai_sram.u_sram.gen_bank\[10\].csb1 | 591.02µm
net3377 | 590.97µm
net20889 | 590.84µm
i_soc.i_cpu.core_i.ex_stage_i.mult_dot_op_b_i\[2\] | 590.69µm
i_soc.i_cpu.core_i.if_stage_i._080_ | 590.645µm
i_soc.i_ai_accel._04541_ | 590.62µm
i_soc.i_cpu.core_i.id_stage_i._1203_ | 590.47µm
net1765 | 590.32µm
net734 | 590.04µm
i_soc.i_ai_accel.cw_raddr\[1\] | 589.16µm
i_soc.i_qspi._07446_ | 589.02µm
i_soc.i_qspi.cmd_tx_data\[24\] | 588.92µm
net699 | 588.59µm
i_soc.i_qspi.cmd_tx_data\[19\] | 588.01µm
net9234 | 587.96µm
net1773 | 587.755µm
i_soc.i_cpu.core_i.id_stage_i._0937_ | 587.74µm
net3551 | 587.68µm
i_soc.i_dm_top.i_dm_mem._0423_ | 587.475µm
net8714 | 587.41µm
net14506 | 587.4µm
net3860 | 587.33µm
net2502 | 587.325µm
clknet_2_0_0_i_soc.i_cpu.core_i.clk | 587.25µm
net732 | 587.15µm
net4111 | 586.985µm
clknet_6_44__leaf_clk_i_regs | 586.65µm
net1767 | 585.995µm
i_soc.i_cpu.core_i.ex_stage_i.mult_i.op_c_i\[9\] | 585.94µm
net2177 | 585.925µm
i_soc.i_ai_accel.cw_waddr\[5\] | 585.87µm
i_soc.i_cpu.core_i.ex_stage_i.mult_i.op_c_i\[20\] | 585.41µm
net5510 | 584.96µm
net20739 | 584.56µm
i_soc.i_cpu.core_i.if_stage_i._076_ | 584.325µm
net14471 | 583.8µm
i_soc.i_cpu.core_i.id_stage_i.register_file_i._0995_ | 583.605µm
i_soc.i_cpu.core_i.alu_operand_c_ex\[25\] | 583.415µm
clknet_6_12__leaf_clk_i_regs | 583.26µm
i_soc.i_cpu.core_i.ex_stage_i.mult_i.op_b_i\[20\] | 583.02µm
i_soc.i_crossbar._0200_ | 582.94µm
i_soc.i_cpu.core_i.ex_stage_i.alu_i._2271_ | 582.69µm
net1743 | 582.1µm
net2285 | 581.84µm
i_soc.i_cpu.core_i.id_stage_i._1457_ | 581.82µm
net701 | 581.65µm
i_soc.i_cpu.core_i.ex_stage_i.mult_i.result_o\[23\] | 581.61µm
net8657 | 581.46µm
i_soc.i_cpu.core_i.clk | 581.21µm
i_soc.i_cpu.core_i.ex_stage_i.mult_dot_op_b_i\[6\] | 581.04µm
net1762 | 580.9µm
net3972 | 580.84µm
clknet_6_1__leaf_clk_i_regs | 580.79µm
i_soc.i_cpu.core_i.ex_stage_i.mult_i.op_c_i\[29\] | 580.48µm
net2360 | 580.48µm
net18622 | 580.28µm
i_soc.i_cpu.core_i.id_stage_i.decoder_i.instr_rdata_i\[8\] | 579.375µm
net4095 | 579.32µm
net4091 | 579.21µm
i_soc.i_cpu.core_i.cs_registers_i.pc_id_i\[28\] | 579.1µm
net2178 | 578.55µm
net510 | 578.24µm
net20990 | 577.6µm
i_soc.i_qspi._05586_ | 577.22µm
i_soc.i_cpu.core_i.cs_registers_i._1000_ | 577.12µm
net3779 | 576.78µm
net2367 | 576.52µm
i_soc.i_cpu.core_i.ex_stage_i.mult_i.result_o\[18\] | 576.49µm
net300 | 576.45µm
net3762 | 576.45µm
clknet_3_1_0_clk_i_regs | 576.36µm
i_soc.i_periph_decoder._0075_ | 575.94µm
i_soc.i_qspi.rx_rd_ptr\[2\] | 575.83µm
i_soc.i_data_sram.u_sram.gen_bank\[2\].csb0 | 575.52µm
i_soc.i_crossbar._0202_ | 575.44µm
i_soc.i_cpu.core_i.ex_stage_i.mult_dot_op_c_i\[0\] | 575.14µm
net4093 | 574.88µm
net2884 | 574.76µm
i_soc.i_cpu.core_i.ex_stage_i.mult_i.op_c_i\[13\] | 574.59µm
net1718 | 574.16µm
net1842 | 574.01µm
net3272 | 573.99µm
net580 | 573.86µm
net3964 | 573.6µm
net1971 | 573.58µm
i_soc.i_cpu.core_i.ex_stage_i.mult_i.result_o\[14\] | 573.4µm
i_soc.dmi_req\[24\] | 573.295µm
net8726 | 572.51µm
i_soc.i_cpu.core_i.cs_registers_i._1005_ | 572.415µm
i_soc.i_cpu.core_i.id_stage_i._0936_ | 572.24µm
i_soc.i_ai_accel.cur_ib\[1\] | 571.94µm
net1712 | 571.46µm
clknet_2_1_1_clk_i | 571.12µm
i_soc.i_crossbar.instr_sram_mst.aw_addr\[2\] | 571µm
net20925 | 570.76µm
i_soc.ai_sram_bus.w_data\[29\] | 570.58µm
net3024 | 570.47µm
net4793 | 570.29µm
net959 | 569.97µm
i_soc.i_cpu.core_i.ex_stage_i.mult_i.op_c_i\[22\] | 569.735µm
i_soc.i_cpu.core_i.cs_registers_i._1023_ | 569.37µm
i_soc.dmi_req\[17\] | 568.995µm
i_soc.i_cpu.core_i.alu_operand_b_ex\[19\] | 568.84µm
i_soc.i_cpu.core_i.ex_stage_i.mult_dot_op_a_i\[9\] | 568.58µm
i_soc.dm_addr\[3\] | 568.49µm
net341 | 567.83µm
clknet_2_1_0_i_soc.i_cpu.core_i.clk | 567.83µm
i_soc.i_ai_sram.u_sram.gen_bank\[14\].csb1 | 567.08µm
i_soc.i_cpu.core_i.ex_stage_i.alu_i._2036_ | 566.75µm
net4790 | 566.55µm
net448 | 565.78µm
i_soc.i_cpu.core_i.ex_stage_i.mult_i.result_o\[29\] | 565.67µm
i_soc.i_cpu.core_i.ex_stage_i.mult_i.result_o\[20\] | 565.6µm
net3792 | 565.495µm
i_soc.i_cpu.core_i.ex_stage_i.alu_i._0341_ | 564.92µm
net20880 | 564.9µm
net9311 | 564.76µm
i_soc.i_cpu.core_i.ex_stage_i.mult_i.result_o\[10\] | 564.48µm
net4040 | 564.44µm
i_soc.i_qspi._05280_ | 564.14µm
i_soc.i_cpu.core_i.if_stage_i._077_ | 563.745µm
i_soc.i_cpu.core_i.ex_stage_i.mult_i.op_b_i\[18\] | 563.65µm
i_soc.i_cpu.core_i.ex_stage_i.mult_i.result_o\[13\] | 563.38µm
i_soc.cpu_data_bus.ar_addr\[2\] | 562.93µm
i_soc.i_cpu.core_i.bmask_a_ex\[3\] | 562.055µm
i_soc.dmi_req\[25\] | 561.76µm
net2500 | 561.67µm
i_soc.i_cpu.core_i.alu_operand_c_ex\[24\] | 561.51µm
net20108 | 561.36µm
net19892 | 561.3µm
net2903 | 561.225µm
clknet_6_54__leaf_clk_i_regs | 561.015µm
net8647 | 560.7µm
i_soc.ai_sram_bus.w_data\[7\] | 560.24µm
net1749 | 560.215µm
i_soc.i_cpu.core_i.ex_stage_i.mult_dot_signed_i\[0\] | 559.875µm
net1709 | 559.845µm
i_soc.i_ai_accel.cw_waddr\[4\] | 559.59µm
net2351 | 559.21µm
i_soc.i_cpu.core_i.ex_stage_i.mult_i._04547_ | 559.08µm
net3020 | 558.83µm
net10513 | 558.75µm
clknet_1_1_0_clk_i_regs | 558.64µm
net4567 | 558.57µm
net1697 | 558.23µm
net2486 | 558.06µm
net21070 | 557.7µm
i_soc.i_qspi._05435_ | 557.52µm
net3982 | 557.5µm
i_soc.i_cpu.core_i.cs_registers_i._0903_ | 557.075µm
i_soc.i_ai_accel._08519_ | 557.07µm
i_soc.i_cpu.core_i.ex_stage_i.mult_i.imm_i\[3\] | 556.98µm
clknet_leaf_9_clk_i | 556.975µm
net330 | 556.915µm
i_soc.i_ai_accel._10326_ | 556.845µm
i_soc.i_cpu.core_i.alu_operand_c_ex\[29\] | 556.53µm
i_soc.cpu_data_bus.ar_addr\[4\] | 556.52µm
i_soc.i_cpu.core_i.cs_registers_i._0956_ | 556.42µm
net3224 | 556.19µm
net9298 | 555.68µm
i_soc.i_qspi._07411_ | 555.64µm
net7615 | 555.43µm
i_soc.i_qspi._05575_ | 555.21µm
i_soc.i_cpu.core_i.ex_stage_i.mult_i.op_c_i\[7\] | 555.18µm
net5038 | 554.94µm
i_soc.i_cpu.core_i.id_stage_i.register_file_i._2904_ | 554.84µm
net21258 | 554.4µm
net2813 | 554.07µm
net9293 | 553.83µm
clknet_5_13__leaf_i_soc.i_cpu.core_i.clk | 553.795µm
i_soc.i_uart_0.i_uart_rx.prescale\[15\] | 553.445µm
i_soc.i_cpu.core_i.id_stage_i.register_file_i._3704_ | 553.08µm
net18180 | 552.76µm
i_soc.i_ai_accel.cw_waddr\[6\] | 552.73µm
i_soc.i_cpu.core_i.bmask_a_ex\[2\] | 552.69µm
net20049 | 552.52µm
i_soc.i_cpu.core_i.cs_registers_i.pc_id_i\[23\] | 552.335µm
i_soc.i_qspi._05118_ | 552.05µm
i_soc.i_cpu.core_i.cs_registers_i.pc_id_i\[19\] | 551.65µm
clknet_6_26__leaf_clk_i_regs | 551.58µm
i_soc.i_cpu.core_i.cs_registers_i.pc_id_i\[16\] | 551.53µm
i_soc.i_cpu.core_i.ex_stage_i.mult_i.result_o\[22\] | 551.3µm
net1769 | 551.22µm
i_soc.i_qspi._05172_ | 551.18µm
i_soc.i_cpu.core_i.ex_stage_i.mult_i.op_c_i\[8\] | 550.61µm
i_soc.i_cpu.core_i.cs_registers_i._1114_ | 549.92µm
clknet_6_30__leaf_clk_i_regs | 549.86µm
net4070 | 549.735µm
net3363 | 549.56µm
net338 | 549.39µm
i_soc.i_qspi._05470_ | 549.16µm
i_soc.i_cpu.core_i.ex_stage_i.mult_i._06497_ | 548.995µm
i_soc.i_cpu.core_i.ex_stage_i.mult_dot_op_a_i\[12\] | 547.86µm
net20417 | 547.775µm
net2371 | 547.51µm
net690 | 547.28µm
net1768 | 547.08µm
net1735 | 547µm
i_soc.i_ai_accel.cur_wb\[1\] | 546.94µm
i_soc.i_qspi._05573_ | 546.86µm
clknet_6_7__leaf_clk_i_regs | 546.835µm
net23 | 546.48µm
net2753 | 546.36µm
clknet_leaf_12_clk_i | 546.2µm
net1704 | 546.17µm
clknet_6_22__leaf_clk_i_regs | 546.06µm
net331 | 545.98µm
i_soc.i_cpu.core_i.cs_registers_i._0901_ | 545.88µm
net2173 | 545.685µm
i_soc.dmi_req\[3\] | 545.655µm
clknet_leaf_0_clk_i | 545.39µm
clknet_leaf_27_clk_i | 545.28µm
clknet_leaf_7_clk_i | 545.21µm
net904 | 545.04µm
net22 | 545.02µm
clknet_leaf_28_clk_i | 544.93µm
clknet_leaf_32_clk_i | 544.8µm
i_soc.i_cpu.core_i.ex_stage_i.alu_i.alu_div_i.ResRegEn_S | 544.765µm
i_soc.i_ai_sram.u_sram.gen_bank\[11\].csb1 | 544.28µm
net9303 | 544.2µm
clknet_leaf_2_clk_i | 543.97µm
net1759 | 543.82µm
i_soc.i_cpu.core_i.ex_stage_i.mult_i.op_c_i\[28\] | 543.72µm
clknet_3_4_0_clk_i_regs | 543.66µm
net2340 | 543.44µm
i_soc.i_axi_lite_bridge.m_rready | 542.77µm
net4115 | 542.74µm
i_soc.dmi_req\[22\] | 542.575µm
clknet_leaf_4_clk_i | 542.43µm
i_soc.i_cpu.core_i.ex_stage_i.mult_dot_op_b_i\[7\] | 542.285µm
clknet_leaf_25_clk_i | 542.06µm
net333 | 542.04µm
net2654 | 542.04µm
net3197 | 541.55µm
net24 | 541.3µm
i_soc.i_cpu.core_i.ex_stage_i.mult_dot_op_b_i\[1\] | 541.19µm
net316 | 541.165µm
i_soc.i_qspi._05428_ | 541.16µm
i_soc.i_cpu.core_i.cs_registers_i._0995_ | 540.875µm
net19898 | 540.56µm
net3539 | 540.515µm
i_soc.i_cpu.core_i.ex_stage_i.mult_i.op_b_i\[21\] | 540.29µm
i_soc.i_cpu.core_i.id_stage_i.register_file_i._3808_ | 540.18µm
i_soc.i_ai_accel._04645_ | 540.16µm
net1744 | 540.12µm
i_soc.i_ai_accel.cw_waddr\[7\] | 539.96µm
i_soc.i_instr_sram.u_sram.gen_bank\[3\].csb0 | 539.92µm
net709 | 539.9µm
i_soc.i_cpu.core_i.data_we_ex | 539.82µm
net425 | 539.06µm
net5140 | 539.03µm
net1272 | 538.98µm
i_soc.i_crossbar._0190_ | 538.94µm
i_soc.dmi_req\[6\] | 538.065µm
i_soc.ai_sram_bus.w_data\[20\] | 537.59µm
net1748 | 537.56µm
net1738 | 537.415µm
i_soc.i_cpu.core_i.cs_registers_i._0914_ | 537.33µm
i_soc.i_axi_lite_bridge.m_wdata\[22\] | 537.31µm
net912 | 537.16µm
i_soc.i_cpu.core_i.cs_registers_i._0987_ | 537.14µm
i_soc.i_cpu.core_i.id_stage_i.regfile_data_ra_id\[6\] | 536.93µm
i_soc.i_cpu.core_i.alu_operand_c_ex\[28\] | 536.74µm
i_soc.i_cpu.core_i.id_stage_i._0949_ | 536.385µm
net8904 | 536.16µm
net2503 | 536.145µm
i_soc.i_cpu.core_i.cs_registers_i.pc_id_i\[17\] | 536.135µm
net1741 | 536.01µm
net7614 | 536µm
net1739 | 535.98µm
net8911 | 535.75µm
net2944 | 535.56µm
i_soc.i_cpu.core_i.ex_stage_i.mult_i.op_b_i\[27\] | 535.42µm
net4024 | 535.15µm
i_soc.i_cpu.core_i.alu_operand_b_ex\[26\] | 535.12µm
net5216 | 534.94µm
i_soc.i_crossbar._0206_ | 534.64µm
i_soc.i_cpu.core_i.ex_stage_i.regfile_alu_wdata_fw_o\[16\] | 534.56µm
net3861 | 534.26µm
net21 | 534.12µm
i_soc.i_cpu.core_i.ex_stage_i.alu_i._1452_ | 533.965µm
i_soc.i_cpu.core_i.data_misaligned | 533.94µm
clknet_5_22__leaf_i_soc.i_cpu.core_i.clk | 533.93µm
net2927 | 533.9µm
net185 | 533.84µm
net5014 | 533.7µm
net4566 | 533.51µm
i_soc.i_cpu.core_i.ex_stage_i.regfile_alu_wdata_fw_o\[4\] | 532.97µm
net1843 | 532.73µm
net68 | 532.42µm
net10516 | 532.4µm
net20115 | 532.25µm
net21054 | 532.24µm
net1771 | 532.165µm
clknet_5_15__leaf_i_soc.i_cpu.core_i.clk | 531.84µm
clknet_3_0_0_clk_i_regs | 531.81µm
clknet_leaf_762_clk_i_regs | 531.68µm
i_soc.i_ai_sram.u_sram._017_ | 531.58µm
i_soc.i_cpu.core_i.id_stage_i.decoder_i.instr_rdata_i\[12\] | 530.975µm
net1151 | 530.965µm
net20287 | 530.74µm
net21267 | 530.68µm
i_soc.dmi_req\[29\] | 530.3µm
i_soc.i_cpu.core_i.cs_registers_i.pc_id_i\[20\] | 530.13µm
i_soc.i_crossbar._0196_ | 529.74µm
i_soc.i_qspi._05577_ | 529.7µm
net2355 | 529.65µm
net3365 | 529.11µm
i_soc.i_qspi.cmd_tx_data\[18\] | 529.02µm
net710 | 529.02µm
i_soc.i_cpu.core_i.cs_registers_i.pc_id_i\[31\] | 529.015µm
net18077 | 528.8µm
net18151 | 528.62µm
net1705 | 528.49µm
net2552 | 528.34µm
net347 | 528µm
i_soc.i_ai_accel.cw_waddr\[3\] | 527.87µm
net322 | 527.64µm
net2711 | 527.32µm
net666 | 527.31µm
i_soc.i_crossbar._0184_ | 527.29µm
net2901 | 527.08µm
net8804 | 527.04µm
i_soc.i_crossbar.instr_sram_mst.aw_addr\[3\] | 527µm
net3320 | 526.7µm
net572 | 526.41µm
net2498 | 526.37µm
i_soc.i_cpu.core_i.branch_decision | 526.15µm
net10396 | 526.14µm
net2379 | 525.91µm
i_soc.i_cpu.core_i.id_stage_i.decoder_i.instr_rdata_i\[10\] | 525.81µm
i_soc.i_ai_accel._04711_ | 525.67µm
i_soc.i_axi_lite_bridge.m_wdata\[23\] | 525.65µm
net1898 | 525.6µm
net1740 | 525.47µm
delaynet_32_clk | 525.385µm
net2059 | 524.79µm
i_soc.i_cpu.core_i.cs_registers_i.pc_id_i\[21\] | 524.415µm
clknet_6_51__leaf_clk_i_regs | 524.02µm
net3973 | 523.51µm
i_soc.i_cpu.core_i.cs_registers_i._0919_ | 523.4µm
i_soc.i_axi_lite_bridge.m_wdata\[21\] | 523.36µm
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
net1757 | 503.2µm
i_soc.i_uart_1._0496_ | 502.8µm
net65 | 502.76µm
i_soc.i_ai_accel._04629_ | 502.7µm
i_soc.i_cpu.core_i.id_stage_i.register_file_i._3807_ | 502.48µm
net21259 | 502.42µm
i_soc.i_qspi._05512_ | 502.35µm
net12180 | 502.26µm
clknet_3_6_0_clk_i_regs | 502.19µm
i_soc.i_cpu.core_i.id_stage_i.decoder_i.instr_rdata_i\[9\] | 502.115µm
net346 | 501.92µm
i_soc.i_cpu.core_i.id_stage_i.jump_target_o\[19\] | 501.86µm
net3375 | 501.64µm
net550 | 501.63µm
net2339 | 501.62µm
net3967 | 500.92µm
i_soc.i_cpu.core_i.ex_stage_i.mult_i.op_c_i\[27\] | 500.79µm
i_soc.i_cpu.core_i.ex_stage_i.mult_i.op_c_i\[12\] | 500.76µm
i_soc.cpu_to_ai_sram_bus.b_valid | 500.74µm
i_soc.i_cpu.core_i.ex_stage_i.alu_i._2637_ | 500.74µm
i_soc.i_cpu.core_i.id_stage_i._1045_ | 500.72µm
net60 | 500.64µm
net2342 | 500.525µm
i_soc.i_cpu.core_i.id_stage_i.regfile_data_ra_id\[14\] | 500.46µm
net2808 | 499.73µm
net2405 | 499.72µm
net21238 | 499.61µm
i_soc.i_crossbar._0188_ | 499.54µm
i_soc.i_qspi._05434_ | 499.36µm
i_soc.i_cpu.core_i.ex_stage_i.mult_i.op_b_i\[9\] | 499.3µm
i_soc.i_cpu.core_i.ex_stage_i.mult_dot_op_b_i\[31\] | 499.28µm
net700 | 499.18µm
i_soc.i_qspi._05431_ | 499.1µm
i_soc.i_cpu.core_i.id_stage_i.jump_target_o\[10\] | 498.995µm
clknet_3_5_0_clk_i_regs | 498.95µm
i_soc.i_cpu.core_i.id_stage_i.register_file_i._3446_ | 498.89µm
i_soc.i_cpu.core_i.ex_stage_i.regfile_alu_wdata_fw_o\[21\] | 498.84µm
i_soc.i_qspi._04740_ | 498.72µm
net556 | 498.6µm
net1783 | 498.44µm
i_soc.i_cpu.core_i.cs_registers_i._0482_ | 498.29µm
net1737 | 498.16µm
net1723 | 498.12µm
i_soc.cpu_to_ai_sram_bus.b_ready | 497.94µm
clknet_6_46__leaf_clk_i_regs | 497.915µm
i_soc.i_cpu.core_i.ex_stage_i.alu_i._1694_ | 497.77µm
i_soc.cpu_to_ai_sram_bus.aw_valid | 497.74µm
net1194 | 497.59µm
i_soc.i_cpu.core_i.id_stage_i.register_file_i._3305_ | 496.99µm
i_soc.i_cpu.core_i.id_stage_i.regfile_data_ra_id\[11\] | 496.83µm
i_soc.i_cpu.core_i.id_stage_i.jump_target_o\[15\] | 496.78µm
net1779 | 496.675µm
net4795 | 496.6µm
net8655 | 496.34µm
i_soc.i_cpu.core_i.ex_stage_i.mult_i._06733_ | 496.275µm
net583 | 496.045µm
i_soc.i_cpu.core_i.id_stage_i._1048_ | 495.82µm
i_soc.i_qspi._05603_ | 495.78µm
i_soc.i_cpu.core_i.if_stage_i._081_ | 495.755µm
net2892 | 495.73µm
i_soc.i_qspi.ccr_dir | 495.355µm
net737 | 495.32µm
clknet_6_24__leaf_clk_i_regs | 495.22µm
net2993 | 495.16µm
net3643 | 495.14µm
clknet_6_52__leaf_clk_i_regs | 494.96µm
i_soc.i_crossbar._0186_ | 494.88µm
net19916 | 494.66µm
i_soc.i_ai_accel.co_wdata\[15\] | 494.52µm
net610 | 494.44µm
i_soc.i_cpu.core_i.cs_registers_i.pc_id_i\[27\] | 494.43µm
i_soc.i_ai_accel._10352_ | 494.22µm
i_soc.i_cpu.core_i.ex_stage_i.mult_i._10945_ | 494.18µm
i_soc.i_qspi._05430_ | 494.18µm
i_soc.i_cpu.core_i.id_stage_i.regfile_data_ra_id\[8\] | 494.08µm
net5749 | 494.015µm
i_soc.i_cpu.core_i.ex_stage_i.alu_i._2773_ | 493.95µm
i_soc.i_qspi._05410_ | 493.9µm
i_soc.i_ai_accel._04649_ | 493.54µm
net5155 | 493.52µm
net8899 | 493.455µm
net3980 | 493.29µm
net3227 | 493.13µm
i_soc.i_ai_accel.co_waddr\[6\] | 493.12µm
i_soc.i_ai_accel.im_waddr\[8\] | 493.12µm
i_soc.i_cpu.core_i.ex_stage_i.mult_i.op_c_i\[30\] | 493.01µm
i_soc.i_cpu.core_i.id_stage_i._0988_ | 492.825µm
net1990 | 492.74µm
net5742 | 492.7µm
net18196 | 492.6µm
net2995 | 492.35µm
net5610 | 492.3µm
net4660 | 491.785µm
i_soc.i_cpu.core_i.ex_stage_i.alu_i._1381_ | 491.74µm
net1772 | 491.74µm
net5644 | 491.46µm
net1693 | 491.355µm
net2457 | 491.195µm
net2179 | 491.105µm
net5748 | 490.95µm
i_soc.i_cpu.core_i.id_stage_i.register_file_i._3269_ | 490.88µm
clknet_leaf_129_clk_i_regs | 490.86µm
i_soc.i_cpu.core_i.id_stage_i.decoder_i.instr_rdata_i\[11\] | 490.855µm
i_soc.i_ai_sram.u_sram.gen_bank\[2\].csb1 | 490.68µm
i_soc.cpu_to_ai_sram_bus.aw_ready | 490.64µm
net14438 | 490.62µm
net225 | 490.48µm
i_soc.i_cpu.core_i.alu_operand_b_ex\[16\] | 490.37µm
i_soc.data_sram_bus.ar_addr\[12\] | 490.04µm
net4876 | 489.975µm
net20945 | 489.72µm
net4832 | 489.58µm
i_soc.i_qspi._05547_ | 489.36µm
i_soc.i_qspi._05416_ | 489.26µm
net2370 | 489.12µm
i_soc.i_instr_sram.u_sram.dout\[4\] | 489.09µm
net1713 | 488.97µm
i_soc.i_cpu.core_i.id_stage_i.decoder_i.mult_int_en_o | 488.8µm
net18206 | 488.54µm
net9120 | 488.48µm
net2222 | 488.395µm
i_soc.i_ai_accel._09596_ | 488.2µm
i_soc.i_qspi._05596_ | 488.17µm
net5364 | 488.1µm
net10685 | 487.9µm
net3018 | 487.78µm
net5639 | 487.74µm
net9092 | 487.61µm
net3650 | 487.55µm
net8819 | 487.5µm
net606 | 487.42µm
i_soc.i_cpu.core_i.cs_registers_i.csr_rdata_o\[18\] | 487.365µm
net3221 | 487.355µm
i_soc.i_crossbar._0164_ | 487.3µm
i_soc.i_qspi._05417_ | 487.23µm
i_soc.i_qspi._05010_ | 487µm
i_soc.i_dm_top.i_dm_csrs._0817_ | 486.99µm
net5061 | 486.56µm
net5149 | 486.56µm
net7601 | 486.49µm
i_soc.i_periph_decoder.qspi_wdata\[0\] | 486.38µm
net1774 | 486.31µm
net3774 | 486.08µm
i_soc.cpu_to_ai_sram_bus.r_valid | 485.86µm
net10433 | 485.84µm
net8691 | 485.625µm
net739 | 485.44µm
i_soc.i_cpu.core_i.ex_stage_i.mult_i._04951_ | 485.4µm
net1702 | 485.055µm
i_soc.i_data_sram.u_sram.gen_bank\[2\].csb1 | 485.04µm
i_soc.i_cpu.core_i.ex_stage_i.mult_dot_op_b_i\[9\] | 484.94µm
net2374 | 484.88µm
i_soc.i_instr_sram.u_sram.gen_bank\[3\].csb1 | 484.28µm
i_soc.i_qspi._05334_ | 484.24µm
net8788 | 484.195µm
net1777 | 484.15µm
i_soc.i_ai_accel._04534_ | 483.86µm
net3127 | 483.62µm
clknet_6_43__leaf_clk_i_regs | 483.46µm
i_soc.i_cpu.core_i.ex_stage_i.mult_i.op_c_i\[6\] | 483.09µm
net3772 | 483.02µm
i_soc.dmi_req\[36\] | 482.97µm
i_soc.i_qspi.cmd_tx_flush | 482.84µm
i_soc.i_ai_accel._04642_ | 482.8µm
i_soc.i_qspi._06797_ | 482.76µm
net5743 | 482.68µm
i_soc.i_cpu.core_i.id_stage_i._0932_ | 482.51µm
i_soc.cpu_to_ai_sram_bus.w_valid | 482.41µm
net8761 | 482.23µm
i_soc.i_qspi._05477_ | 482.2µm
i_soc.i_cpu.core_i.cs_registers_i._0905_ | 482.125µm
i_soc.i_cpu.core_i.cs_registers_i._0465_ | 482.08µm
i_soc.cpu_to_ai_sram_bus.w_ready | 481.86µm
i_soc.i_crossbar._0168_ | 481.72µm
i_soc.dmi_req\[8\] | 481.27µm
i_soc.i_ai_accel.co_wdata\[11\] | 481.26µm
net10683 | 481.26µm
clknet_2_2_0_i_soc.i_cpu.core_i.clk | 481.16µm
net1181 | 481.12µm
i_soc.i_crossbar._0166_ | 481.1µm
net3099 | 480.975µm
i_soc.i_cpu.core_i.id_stage_i._1535_ | 480.94µm
net566 | 480.83µm
i_soc.i_cpu.core_i.id_stage_i.decoder_i.mult_operator_o\[2\] | 480.46µm
i_soc.i_qspi._04632_ | 480.46µm
net5649 | 480.43µm
net2464 | 480.405µm
net4322 | 480.29µm
i_soc.i_ai_accel._10344_ | 480.06µm
net3228 | 479.92µm
net222 | 479.68µm
clknet_6_42__leaf_clk_i_regs | 479.55µm
i_soc.i_cpu.core_i.ex_stage_i.alu_i._1334_ | 479.54µm
i_soc.ai_sram_bus.w_data\[26\] | 479.5µm
i_soc.i_axi_lite_bridge.m_wdata\[24\] | 479.44µm
i_soc.i_qspi._05602_ | 479.23µm
net2891 | 479.16µm
net10562 | 478.975µm
net7522 | 478.955µm
i_soc.i_qspi._05420_ | 478.94µm
net14607 | 478.76µm
i_soc.i_cpu.core_i.cs_registers_i.pc_id_i\[14\] | 478.75µm
net21312 | 478.6µm
net5154 | 478.4µm
net398 | 477.86µm
net2066 | 477.655µm
net3767 | 477.51µm
net1728 | 477.43µm
net1962 | 477.43µm
net4866 | 477.35µm
i_soc.i_ai_accel._10335_ | 477.34µm
i_soc.i_cpu.core_i.ex_stage_i.mult_i._04429_ | 477.16µm
net8767 | 477.14µm
net3458 | 477.11µm
clknet_5_6__leaf_i_soc.i_cpu.core_i.clk | 477.08µm
net7532 | 476.96µm
net9231 | 476.94µm
net2719 | 476.82µm
net10588 | 476.54µm
i_soc.i_ai_sram.u_sram.gen_bank\[5\].csb0 | 476.26µm
i_soc.i_ai_accel.state\[13\] | 476.06µm
i_soc.i_ai_accel._06978_ | 476.02µm
net471 | 475.97µm
i_soc.i_ai_accel._05285_ | 475.82µm
net491 | 475.82µm
i_soc.i_cpu.core_i.ex_stage_i.regfile_alu_waddr_fw_o\[0\] | 475.64µm
net8807 | 475.54µm
i_soc.i_cpu.core_i.ex_stage_i.mult_i.op_c_i\[11\] | 475.42µm
net224 | 475.34µm
i_soc.i_ai_accel._05286_ | 475.29µm
i_soc.i_cpu.core_i.id_stage_i.regfile_data_ra_id\[0\] | 475.18µm
i_soc.i_gpio._082_ | 475.18µm
net591 | 474.98µm
net2369 | 474.83µm
net2380 | 474.63µm
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
i_soc.i_qspi._04470_ | 432µm
net3226 | 431.96µm
net2650 | 431.85µm
i_soc.i_cpu.core_i.ex_stage_i.mult_i._04298_ | 431.845µm
net2474 | 431.55µm
net5063 | 431.39µm
net2550 | 431.15µm
i_soc.i_uart_1._0605_ | 430.97µm
net1159 | 430.84µm
i_soc.i_qspi._06951_ | 430.78µm
net129 | 430.725µm
i_soc.i_cpu.core_i.id_stage_i.register_file_i._2981_ | 430.72µm
net7759 | 430.6µm
clknet_6_8__leaf_clk_i_regs | 430.415µm
net1963 | 430.215µm
net84 | 430.2µm
net3790 | 430.18µm
net2703 | 430.165µm
i_soc.i_qspi._05576_ | 429.82µm
i_soc.i_cpu.core_i.ex_stage_i.mult_i._05051_ | 429.535µm
clknet_6_36__leaf_clk_i_regs | 429.42µm
net2009 | 429.415µm
i_soc.i_crossbar._0176_ | 429.38µm
i_soc.i_data_sram.u_sram.dout\[60\] | 429.24µm
net3793 | 429.155µm
clknet_5_16__leaf_i_soc.i_cpu.core_i.clk | 428.92µm
net1691 | 428.86µm
i_soc.i_cpu.core_i.id_stage_i.register_file_i._1126_ | 428.84µm
net1993 | 428.8µm
i_soc.ai_busy | 428.6µm
i_soc.i_cpu.core_i.id_stage_i._1531_ | 428.57µm
i_soc.i_cpu.core_i.ex_stage_i.mult_i.op_c_i\[1\] | 428.54µm
net3521 | 428.46µm
i_soc.i_cpu.core_i.ex_stage_i.mult_i._10628_ | 428.38µm
net2778 | 428.355µm
net2651 | 428.23µm
net3222 | 428.22µm
net115 | 428.2µm
net10676 | 428.16µm
i_soc.i_qspi._08348_ | 428.1µm
i_soc.i_timer._0442_ | 428.1µm
net1974 | 427.96µm
i_soc.i_qspi._08294_ | 427.9µm
net20196 | 427.86µm
net4020 | 427.75µm
net5066 | 427.74µm
net15277 | 427.5µm
net722 | 427.37µm
net624 | 427.29µm
net3765 | 427.27µm
i_soc.i_crossbar._0154_ | 427.26µm
net4297 | 427.175µm
net3780 | 427.17µm
net3794 | 426.975µm
net4880 | 426.755µm
i_soc.i_cpu.core_i.cs_registers_i.pc_id_i\[30\] | 426.74µm
i_soc.cpu_to_ai_sram_bus.ar_ready | 426.72µm
net3236 | 426.705µm
i_soc.i_cpu.core_i.id_stage_i.regfile_data_rb_id\[6\] | 426.67µm
i_soc.i_periph_decoder.qspi_wdata\[2\] | 426.63µm
i_soc.i_qspi._07154_ | 426.58µm
net2083 | 426.57µm
net237 | 426.28µm
clknet_5_24__leaf_i_soc.i_cpu.core_i.clk | 426.2µm
i_soc.ai_sram_bus.r_data\[1\] | 426.14µm
net20271 | 426µm
net3188 | 425.95µm
i_soc.i_instr_sram.u_sram.dout\[29\] | 425.57µm
net668 | 425.2µm
i_soc.i_data_sram.u_sram.dout\[35\] | 425.08µm
net5676 | 425µm
i_soc.i_cpu.core_i.id_stage_i.register_file_i._3841_ | 424.96µm
i_soc.i_cpu.core_i.ex_stage_i.mult_i.imm_i\[1\] | 424.935µm
i_soc.i_ai_accel._06556_ | 424.55µm
i_soc.i_cpu.core_i.if_stage_i.compressed_decoder_i.is_compressed_o | 424.5µm
i_soc.i_cpu.core_i.cs_registers_i._1239_ | 424.48µm
net3252 | 424.41µm
net20294 | 424.26µm
net1745 | 424.24µm
i_soc.i_qspi._08240_ | 424.2µm
i_soc.i_ai_accel._08394_ | 424.16µm
i_soc.i_ai_accel.co_rdata\[3\] | 424.15µm
i_soc.i_cpu.core_i.ex_stage_i.mult_i._11694_ | 424.12µm
i_soc.i_cpu.core_i.ex_stage_i.alu_i._1994_ | 423.97µm
net1992 | 423.82µm
i_soc.i_cpu.core_i.ex_stage_i.regfile_wdata_wb_o\[6\] | 423.67µm
i_soc.cpu_to_ai_sram_bus.ar_valid | 423.48µm
net4313 | 423.27µm
i_soc.i_ai_accel._07889_ | 423.26µm
net3160 | 423.155µm
i_soc.i_axi_lite_bridge.m_wdata\[26\] | 423.08µm
i_soc.i_cpu.core_i.ex_stage_i.alu_i._1386_ | 423.04µm
net8944 | 423.04µm
net1694 | 422.76µm
i_soc.i_qspi._05570_ | 422.71µm
net18110 | 422.68µm
net2779 | 422.47µm
i_soc.i_cpu.core_i.id_stage_i.register_file_i._2862_ | 422.42µm
i_soc.i_cpu.core_i.ex_stage_i.alu_i._1420_ | 422.27µm
net1902 | 422.24µm
net5671 | 422.2µm
net2182 | 422.195µm
i_soc.i_data_sram.u_sram.dout\[61\] | 422µm
net3653 | 421.965µm
i_soc.i_cpu.core_i.cs_registers_i.csr_rdata_o\[26\] | 421.76µm
net3769 | 421.67µm
i_soc.i_qspi._08402_ | 421.64µm
net5353 | 421.58µm
net21099 | 421.555µm
i_soc.i_dmi_jtag._168_ | 421.42µm
i_soc.i_periph_decoder._0066_ | 421.365µm
net1476 | 421.36µm
net2162 | 421.36µm
net8906 | 421.28µm
net2442 | 421.26µm
i_soc.i_qspi._06842_ | 421.2µm
i_soc.i_cpu.core_i.ex_stage_i.mult_i._04549_ | 421.12µm
i_soc.dmi_req\[11\] | 421.035µm
net1465 | 420.99µm
net3270 | 420.97µm
net2688 | 420.85µm
i_soc.i_ai_accel._04652_ | 420.55µm
net2670 | 420.535µm
net2943 | 420.53µm
net1696 | 420.46µm
net8667 | 420.42µm
net7537 | 420.12µm
i_soc.i_cpu.core_i.id_stage_i._1040_ | 419.83µm
net1897 | 419.76µm
net19922 | 419.75µm
net4822 | 419.705µm
net18078 | 419.5µm
i_soc.i_ai_accel.co_waddr\[3\] | 419.48µm
i_soc.i_ai_sram.u_sram.rsel_q\[2\] | 419.26µm
i_soc.i_ai_accel._04563_ | 419.08µm
i_soc.i_dm_top.i_dm_csrs._0582_ | 419.02µm
net967 | 418.93µm
net2896 | 418.735µm
i_soc.i_qspi._05686_ | 418.68µm
net1490 | 418.64µm
i_soc.i_cpu.core_i.cs_registers_i.csr_rdata_o\[2\] | 418.58µm
net488 | 418.4µm
i_soc.i_data_sram.u_sram.dout\[33\] | 418.38µm
i_soc.i_dm_top.i_dm_mem._0291_ | 418.34µm
net158 | 418.24µm
net5347 | 418.24µm
net2893 | 418.02µm
i_soc.i_cpu.core_i.ex_stage_i.mult_i._11247_ | 417.98µm
i_soc.dmi_req\[7\] | 417.92µm
net5095 | 417.695µm
net910 | 417.69µm
net447 | 417.48µm
net2018 | 417.42µm
net5089 | 417.35µm
i_soc.i_cpu.core_i.id_stage_i.jump_target_o\[29\] | 417.33µm
i_soc.i_qspi._06214_ | 417.32µm
clknet_6_33__leaf_clk_i_regs | 417.02µm
i_soc.i_periph_decoder.qspi_wdata\[12\] | 417µm
net3785 | 416.98µm
net20001 | 416.82µm
i_soc.i_cpu.core_i.id_stage_i.controller_i.illegal_insn_i | 416.75µm
net1173 | 416.71µm
net1908 | 416.7µm
net2221 | 416.655µm
net3580 | 416.61µm
net2619 | 416.505µm
i_soc.i_cpu.core_i.ex_stage_i.is_decoding_i | 416.5µm
i_soc.i_ai_accel._07215_ | 416.16µm
net3164 | 416.03µm
net4044 | 416.02µm
net4835 | 416.02µm
net3472 | 415.76µm
i_soc.i_cpu.core_i.cs_registers_i._0931_ | 415.74µm
i_soc.i_cpu.core_i.if_stage_i._082_ | 415.69µm
net2526 | 415.63µm
i_soc.i_cpu.core_i.alu_operand_a_ex\[23\] | 415.6µm
i_soc.i_dm_top.i_dm_csrs._0998_ | 415.56µm
net559 | 415.48µm
net5084 | 415.46µm
i_soc.cpu_data_bus.ar_addr\[17\] | 415.45µm
net1474 | 415.4µm
clknet_6_60__leaf_clk_i_regs | 415.315µm
i_soc.i_crossbar._0047_ | 415.15µm
net20674 | 415µm
i_soc.i_cpu.core_i.ex_stage_i.alu_i._2084_ | 414.995µm
i_soc.i_cpu.core_i.id_stage_i.jump_target_o\[26\] | 414.9µm
i_soc.i_axi_lite_bridge.m_awaddr\[0\] | 414.875µm
net2225 | 414.835µm
net1140 | 414.735µm
i_soc.i_qspi._05437_ | 414.39µm
i_soc.i_qspi._05432_ | 414.28µm
net20888 | 414.28µm
i_soc.i_cpu.core_i.ex_stage_i.mult_i.op_c_i\[2\] | 414µm
i_soc.i_cpu.core_i.load_store_unit_i.count_down | 413.97µm
i_soc.i_dm_top.i_dm_csrs._1425_ | 413.905µm
net3388 | 413.9µm
i_soc.i_ai_accel._05230_ | 413.865µm
net3649 | 413.85µm
i_soc.i_i2c.data_idx\[1\] | 413.83µm
i_soc.dmi_req\[9\] | 413.755µm
net10703 | 413.75µm
net5039 | 413.72µm
i_soc.i_data_sram.u_sram.dout\[34\] | 413.59µm
clknet_6_16__leaf_clk_i_regs | 413.58µm
i_soc.i_ai_accel.co_waddr\[4\] | 413.28µm
clknet_1_0_0_clk_i_regs | 413.2µm
net4814 | 413.17µm
net487 | 413.115µm
i_soc.i_cpu.core_i.id_stage_i.jump_target_o\[21\] | 413.09µm
net2898 | 413.03µm
i_soc.i_cpu.core_i.ex_stage_i.mult_i._04550_ | 412.98µm
net21134 | 412.92µm
net4282 | 412.82µm
i_soc.dmi_req\[15\] | 412.7µm
net4824 | 412.525µm
i_soc.i_cpu.core_i.ex_stage_i.mult_dot_op_b_i\[4\] | 412.5µm
i_soc.i_ai_accel._04546_ | 412.46µm
net3579 | 412.455µm
net4048 | 412.38µm
net5076 | 412.34µm
net4994 | 412.32µm
net4855 | 412.28µm
clknet_5_25_0_clk_i_regs | 412.16µm
net196 | 411.82µm
net3117 | 411.82µm
i_soc.i_data_sram.u_sram.dout\[62\] | 411.79µm
net3242 | 411.76µm
i_soc.i_ai_accel.co_rdata\[4\] | 411.72µm
net1139 | 411.69µm
i_soc.i_cpu.core_i.ex_stage_i.mult_i._08974_ | 411.66µm
net3470 | 411.655µm
net4853 | 411.655µm
net20350 | 411.65µm
i_soc.i_cpu.core_i.ex_stage_i.mult_i._04714_ | 411.645µm
i_soc.i_dm_top.i_dm_mem._0413_ | 411.62µm
net100 | 411.48µm
i_soc.i_cpu.core_i.ex_stage_i.alu_i.alu_div_i.OpB_DI\[0\] | 411.37µm
net3817 | 411.3µm
i_soc.i_cpu.core_i.load_store_unit_i._0238_ | 411.28µm
net677 | 411.22µm
i_soc.i_qspi._07045_ | 411.04µm
net20238 | 410.86µm
net2940 | 410.76µm
net1751 | 410.75µm
net2679 | 410.64µm
i_soc.i_instr_sram.u_sram.dout\[30\] | 410.51µm
net3202 | 410.49µm
net2787 | 410.33µm
net2630 | 410.245µm
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
net2072 | 376.9µm
i_soc.i_cpu.core_i.id_stage_i.register_file_i._3560_ | 376.75µm
net3520 | 376.715µm
net3466 | 376.64µm
net3274 | 376.61µm
i_soc.i_cpu.core_i.ex_stage_i.mult_i._06404_ | 376.595µm
i_soc.i_qspi._07462_ | 376.5µm
net3550 | 376.43µm
net5092 | 376.39µm
net8811 | 376.33µm
i_soc.i_dm_top.i_dm_csrs._0542_ | 376.305µm
i_soc.i_qspi._05574_ | 376.305µm
net2004 | 376.29µm
net329 | 376.22µm
net3168 | 376.22µm
i_soc.i_ai_sram.u_sram.rsel_q\[3\] | 376.075µm
net2063 | 376.06µm
net19967 | 376.01µm
net3155 | 375.91µm
net5604 | 375.84µm
net195 | 375.8µm
i_soc.i_dm_top.i_dm_mem._0395_ | 375.7µm
net8832 | 375.66µm
net2533 | 375.58µm
i_soc.i_cpu.core_i.id_stage_i.jump_target_o\[14\] | 375.565µm
i_soc.i_qspi._06059_ | 375.54µm
i_soc.i_cpu.core_i.alu_operator_ex\[0\] | 375.52µm
net1917 | 375.5µm
net604 | 375.47µm
net197 | 375.44µm
net5110 | 375.28µm
net8874 | 375.28µm
net4049 | 375.12µm
net4810 | 375.12µm
i_soc.i_cpu.core_i.ex_stage_i.mult_i.op_b_i\[23\] | 375.08µm
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
