BLogic-Microelectronic/BLogic-MCU/asic/reports/signoff/full_disconnected_pins_table.txt

┏━━━━━━━━━━━━━━━━━━━━━━━━━━━━━━━━━━━┳━━━━━━━━━━━━━━━━━━━━━━━━━━━━━━━━━━━┳━━━━━━━━━━━━━━┳━━━━━━━━━━━━━━━━━━━━━━━━━━━━━━━━━━━┳━━━━━━━━━━━━━━━━━━━━━━━━━━━━━━━━━━━┓
┃ Macro/Instance                    ┃ Power Pins                        ┃ Disconnected ┃ Signal Pins                       ┃ Disconnected                      ┃
┡━━━━━━━━━━━━━━━━━━━━━━━━━━━━━━━━━━━╇━━━━━━━━━━━━━━━━━━━━━━━━━━━━━━━━━━━╇━━━━━━━━━━━━━━╇━━━━━━━━━━━━━━━━━━━━━━━━━━━━━━━━━━━╇━━━━━━━━━━━━━━━━━━━━━━━━━━━━━━━━━━━┩
│ asic_top                          │ VPWR                              │              │ clk_i                             │ gpio_in_i[16]                     │
│                                   │ VGND                              │              │ gpio_in_i[0]                      │ gpio_in_i[17]                     │
│                                   │                                   │              │ gpio_in_i[10]                     │ gpio_in_i[18]                     │
│                                   │                                   │              │ gpio_in_i[11]                     │ gpio_in_i[19]                     │
│                                   │                                   │              │ gpio_in_i[12]                     │ gpio_in_i[20]                     │
│                                   │                                   │              │ gpio_in_i[13]                     │ gpio_in_i[21]                     │
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
│                                   │                                   │              │ i_soc.i_ai_sram.u_sram.gen_bank[… │ i_soc.i_ai_sram.u_sram.gen_bank[… │
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
