BLogic-Microelectronic/BLogic-MCU/images/boot_flow.png

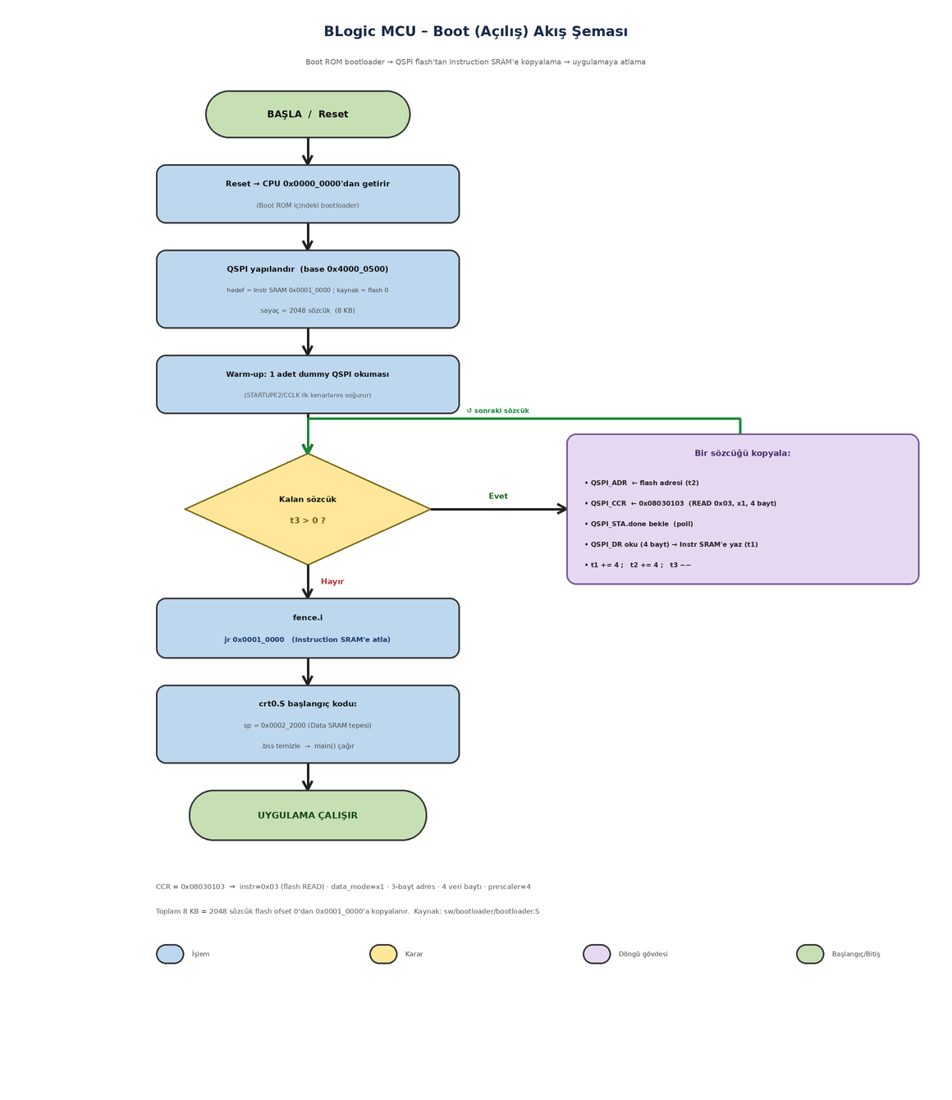
images/boot_flow.png
