BLogic-Microelectronic/BLogic-MCU/images/coverage_terminal_20260909.png

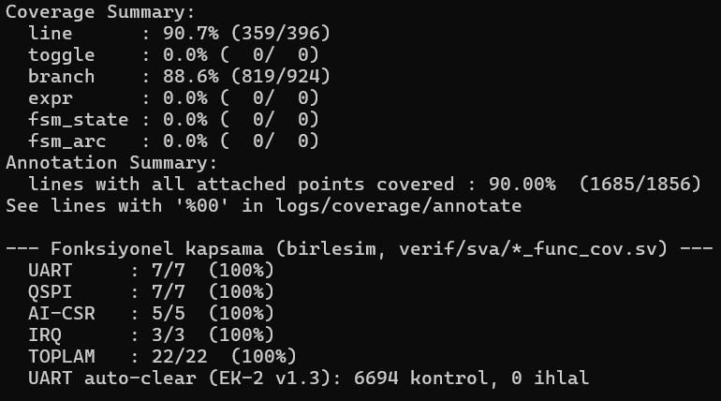
images/coverage_terminal_20260909.png
