BLogic-Microelectronic/BLogic-MCU/images/fpga_clock_qspi.png

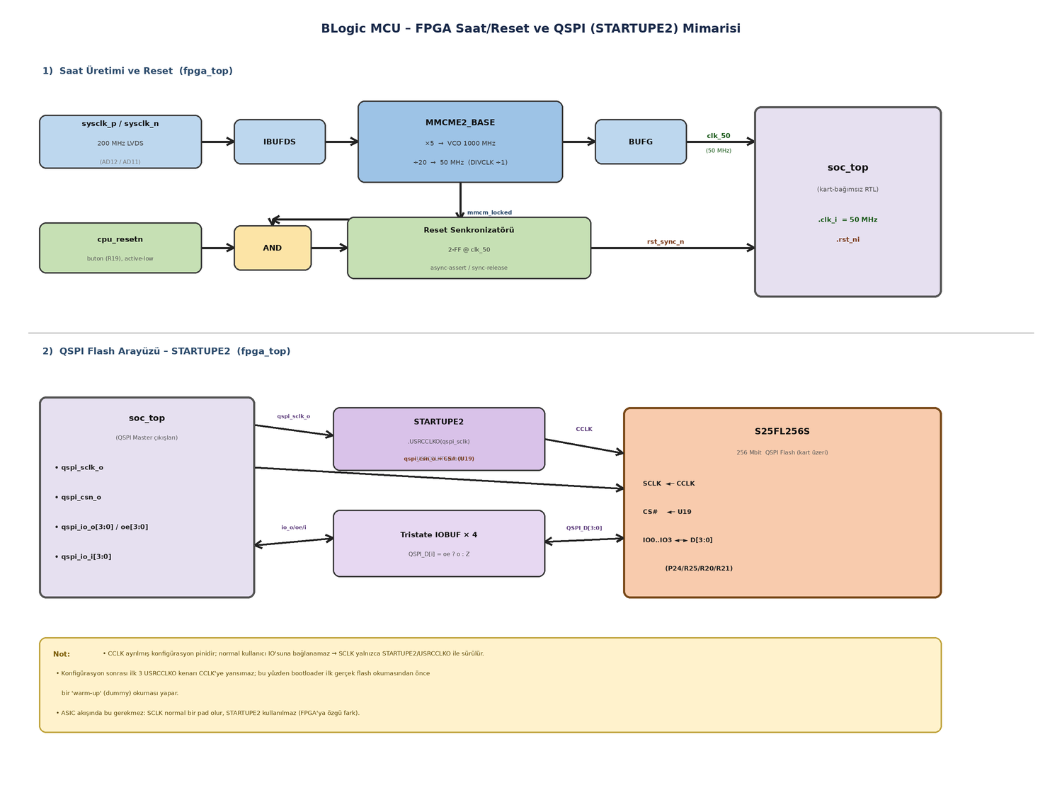
images/fpga_clock_qspi.png
