BLogic-Microelectronic/BLogic-MCU/images/qspi_page_program.png

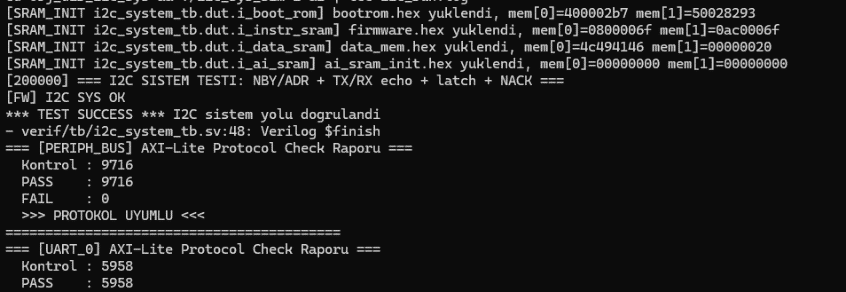
images/qspi_page_program.png
