BLogic-Microelectronic/BLogic-MCU/images/res_designruns.png

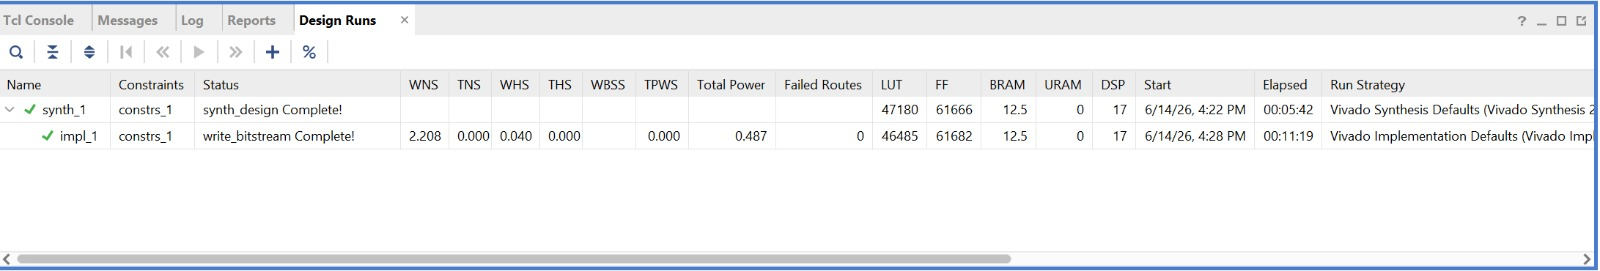
images/res_designruns.png
