BLogic-Microelectronic/BLogic-MCU/images/res_floorplan.png

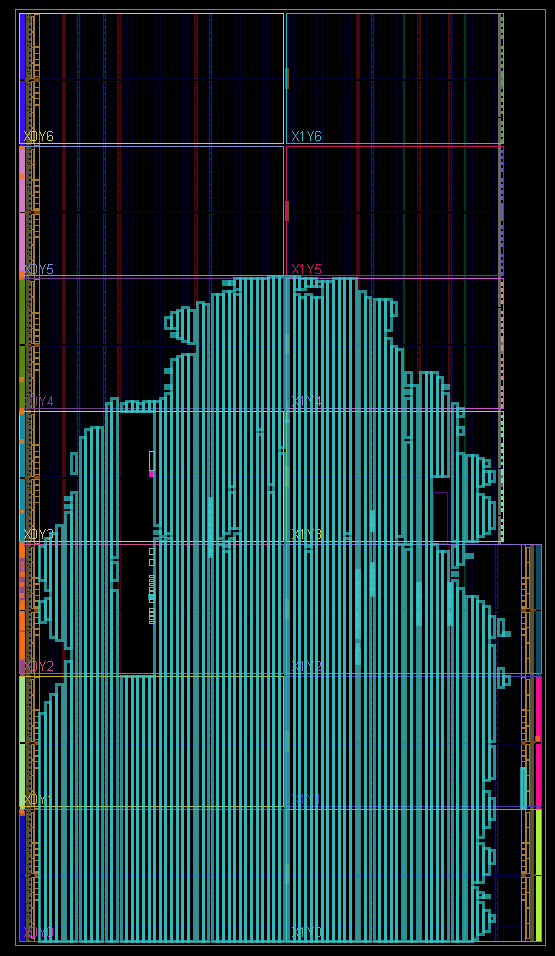
images/res_floorplan.png
