BLogic-Microelectronic/BLogic-MCU/images/res_util.png

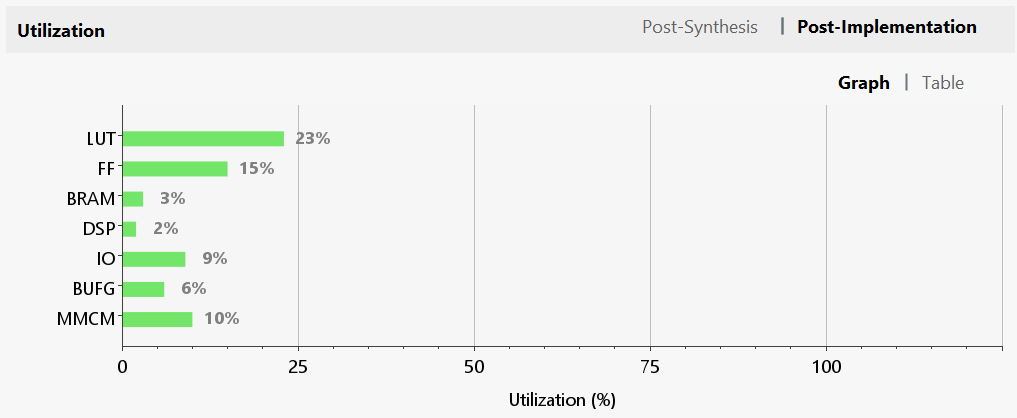
images/res_util.png
