BLogic-Microelectronic/BLogic-MCU/images/uvm_regression_terminal_20260909.png

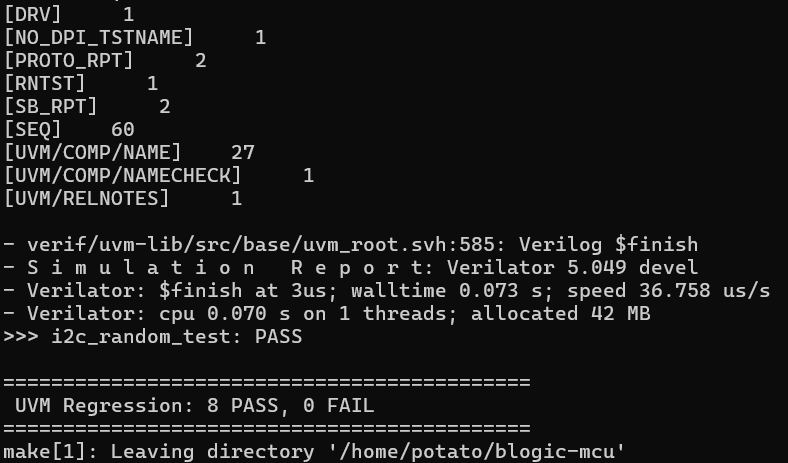
images/uvm_regression_terminal_20260909.png
