BLogic-Microelectronic/BLogic-MCU/verif/coverage_summary.txt

BLogic MCU - line coverage ozeti (make coverage)
tarih     : 2026-09-13
verilator : Verilator 5.052 2026-09-05 rev v5.052
testler   : uart_hello qspi_test gpio_led_test ai_micro_speech_test uart_baud_sweep ai_irq_test isa_compliance_test timer_irq_test uart_stp_reg_test uart1_strm_test qspi_fifo_err_test i2c_soc_test csr_negatif_test qspi_rdpath_test ai_sat_test
olcum     : --coverage-line, SoC seviyesi (15 C testi, tek build, sabit payda)
kapsam    : tasarim RTL'i (15 dosya; JTAG koprusu axi_dm_slave.sv dahil). Haric:
            CV32E40P/PULP ve riscv-dbg vendor kodu, testbench'ler, davranissal
            modeller, SVA checker ve covergroup bind'leri - dogrulama altyapisidir.
            JTAG altsistemi ayrica jtag_smoke_tb ile olculur: make jtag-cov (sonda).
modul bazli TB kapsamasi: verif/coverage_tb_summary.txt (make coverage-tb)
------------------------------------------------------------
Coverage Summary:
  line      : 90.7% (359/396)
  toggle    : 0.0% (  0/  0)
  branch    : 88.5% (818/924)
  expr      : 0.0% (  0/  0)
  fsm_state : 0.0% (  0/  0)
  fsm_arc   : 0.0% (  0/  0)
Annotation Summary:
  lines with all attached points covered : 90.00%  (1685/1856)
See lines with '%00' in logs/coverage/annotate

--- Fonksiyonel kapsama (birlesim, verif/sva/*_func_cov.sv) ---
  UART     : 7/7  (100%)
  QSPI     : 7/7  (100%)
  AI-CSR   : 5/5  (100%)
  IRQ      : 3/3  (100%)
  TOPLAM   : 22/22  (100%)
  UART auto-clear (EK-2 v1.3): 6410 kontrol, 0 ihlal

--- Ekip RTL: kapsanmamis nokta-satir sayilari ---
    (satir bazli sayim; ayni satirdaki branch-yarisi kayiplari icin annotate'e bakin)
  ai_accelerator.sv            : 9
  ai_sram_arbiter.sv           : 0
  soc_top.sv                   : 0
  soc_axi_interconnect.sv      : 0
  periph_decoder.sv            : 0
  axi4_to_axilite_bridge.sv    : annotate yok (nokta uretilmedi: yapisal RTL / waiver / kullanilmiyor)
  obi_to_axi.sv                : 24
  axi_dm_slave.sv              : 22
  uart_axil.sv                 : 0
  uart_stream_axil.sv          : 1
  gpio_axil.sv                 : 0
  timer_axil.sv                : 0
  qspi_master_axil.sv          : 9
  i2c_master_axil.sv           : 3
  boot_rom.sv                  : 4
  axi_sram_wrapper.sv          : 0
  uart_rx.v                    : 5
  uart_tx.v                    : 0

--- JTAG altsistemi (make jtag-cov, jtag_smoke_tb 17 asama; rtl/debug/sim/jtag_cov_summary.txt) ---
  rtl/bus/soc_axi_interconnect.sv                               104    104  100.0%
  rtl/debug/axi_dm_slave.sv                                      49     49  100.0%
  rtl/debug/vendor/riscv-dbg/src/dm_csrs.sv                     239    294   81.3%
  rtl/debug/vendor/riscv-dbg/src/dm_mem.sv                      206    214   96.3%
  rtl/debug/vendor/riscv-dbg/src/dmi_jtag.sv                    102    113   90.3%
  rtl/debug/vendor/riscv-dbg/src/dmi_jtag_tap.sv                116    117   99.1%
  rtl/soc_top.sv                                                 10     10  100.0%
