BLogic-Microelectronic/BLogic-MCU/rtl/debug/sim/jtag_cov_summary.txt

dosya                                                       vuran  satir   yuzde
rtl/ai_accelerator/ai_accelerator.sv                          113    419   27.0%
rtl/ai_accelerator/ai_sram_arbiter.sv                          32     32  100.0%
rtl/asic/boot_rom.sv                                           16     24   66.7%
rtl/bus/obi_to_axi.sv                                          80    103   77.7%
rtl/bus/periph_decoder.sv                                      43     73   58.9%
rtl/bus/soc_axi_interconnect.sv                               104    104  100.0%
rtl/core/cv32e40p/bhv/cv32e40p_sim_clock_gate.sv                2      2  100.0%
rtl/core/cv32e40p/rtl/axi_sram_wrapper.sv                      43     43  100.0%
rtl/core/cv32e40p/rtl/cv32e40p_aligner.sv                      74     82   90.2%
rtl/core/cv32e40p/rtl/cv32e40p_alu.sv                         146    361   40.4%
rtl/core/cv32e40p/rtl/cv32e40p_alu_div.sv                      45     62   72.6%
rtl/core/cv32e40p/rtl/cv32e40p_compressed_decoder.sv          127    386   32.9%
rtl/core/cv32e40p/rtl/cv32e40p_controller.sv                  316    668   47.3%
rtl/core/cv32e40p/rtl/cv32e40p_core.sv                          5      5  100.0%
rtl/core/cv32e40p/rtl/cv32e40p_cs_registers.sv                178    307   58.0%
rtl/core/cv32e40p/rtl/cv32e40p_decoder.sv                     219   1745   12.6%
rtl/core/cv32e40p/rtl/cv32e40p_ex_stage.sv                     37     50   74.0%
rtl/core/cv32e40p/rtl/cv32e40p_ff_one.sv                        5      6   83.3%
rtl/core/cv32e40p/rtl/cv32e40p_fifo.sv                         39     48   81.2%
rtl/core/cv32e40p/rtl/cv32e40p_id_stage.sv                    210    278   75.5%
rtl/core/cv32e40p/rtl/cv32e40p_if_stage.sv                     45     56   80.4%
rtl/core/cv32e40p/rtl/cv32e40p_int_controller.sv               10     54   18.5%
rtl/core/cv32e40p/rtl/cv32e40p_load_store_unit.sv             115    139   82.7%
rtl/core/cv32e40p/rtl/cv32e40p_mult.sv                         46     91   50.5%
rtl/core/cv32e40p/rtl/cv32e40p_obi_interface.sv                40     40  100.0%
rtl/core/cv32e40p/rtl/cv32e40p_prefetch_buffer.sv               1      1  100.0%
rtl/core/cv32e40p/rtl/cv32e40p_prefetch_controller.sv          49     52   94.2%
rtl/core/cv32e40p/rtl/cv32e40p_register_file_ff.sv             17     17  100.0%
rtl/core/cv32e40p/rtl/cv32e40p_sleep_unit.sv                   10     10  100.0%
rtl/core/cv32e40p/rtl/vendor/pulp_platform_common_cells/src/fifo_v3.sv     38     46   82.6%
rtl/core/cv32e40p/rtl/vendor/pulp_platform_common_cells/src/sync.sv      5      5  100.0%
rtl/debug/axi_dm_slave.sv                                      49     49  100.0%
rtl/debug/vendor/common_cells_v1.38.0/cdc_2phase_clearable.sv     46     46  100.0%
rtl/debug/vendor/common_cells_v1.38.0/cdc_4phase.sv            69     77   89.6%
rtl/debug/vendor/common_cells_v1.38.0/cdc_reset_ctrlr.sv      103    131   78.6%
rtl/debug/vendor/riscv-dbg/debug_rom/debug_rom.sv              10     10  100.0%
rtl/debug/vendor/riscv-dbg/src/dm_csrs.sv                     239    294   81.3%
rtl/debug/vendor/riscv-dbg/src/dm_mem.sv                      206    214   96.3%
rtl/debug/vendor/riscv-dbg/src/dm_sba.sv                       59     73   80.8%
rtl/debug/vendor/riscv-dbg/src/dmi_cdc.sv                       7      7  100.0%
rtl/debug/vendor/riscv-dbg/src/dmi_jtag.sv                    102    113   90.3%
rtl/debug/vendor/riscv-dbg/src/dmi_jtag_tap.sv                116    117   99.1%
rtl/debug/vendor/tech_cells_generic/tc_clk.sv                   1      1  100.0%
rtl/peripherals/gpio_axil.sv                                   32     51   62.7%
rtl/peripherals/i2c_master_axil.sv                             65    187   34.8%
rtl/peripherals/qspi_master_axil.sv                           104    328   31.7%
rtl/peripherals/timer_axil.sv                                  39     85   45.9%
rtl/peripherals/uart_axil.sv                                   84    108   77.8%
rtl/peripherals/uart_rx.v                                      28     54   51.9%
rtl/peripherals/uart_stream_axil.sv                            74    150   49.3%
rtl/peripherals/uart_tx.v                                      36     36  100.0%
rtl/soc_top.sv                                                 10     10  100.0%
verif/sva/ai_func_cov.sv                                       17     17  100.0%
verif/sva/axi4_protocol_checker.sv                            100    219   45.7%
verif/sva/axi_lite_protocol_checker.sv                         71     98   72.4%
verif/sva/irq_func_cov.sv                                      14     14  100.0%
verif/sva/qspi_func_cov.sv                                     15     27   55.6%
verif/sva/uart_func_cov.sv                                     28     31   90.3%
