BLogic-Microelectronic/BLogic-MCU/(commit log)

2026-05-26 axi, cv32e40p ve verilog-uart klasörü alt modülden normal klasöre dönüştürüldü ve dosyalar eklendi
2026-05-27 OBI-to-AXI adreslerindeki drop deadlock çözüldü. Artık UART ile HELLO yazılabiliyor.
2026-05-31 gpio'daki led kontrolü yapıldı. çekirdek testleri test edildi. fpga'de bazı testler yapıldı.
2026-06-03 log düzeni + spike lockstep fix + riscv-arch-test eski API entegrasyonu
    [compare_traces.py, sim_main.cpp]
2026-06-08 teknotest PASS + QSPI boot altyapisi (sartname 4.2.2)
    Teknotest (zorunlu juri testi):
    - UART TX bug fix: tx_start tx_en kenari yerine TDR yazimina baglandi
    (cok-byte TX onceden bozuktu, sadece ilk harf gidiyordu)
    - helloworld CPB=54 (Forencich prescale clk/(baud*8))
    - 6 user_files + compile_user_design.tcl tam
    - sw/build: firmware.hex, helloworld.mem, data_mem.hex
    - AXI-Lite protocol checker: 7619 kontrol PASS
    QSPI Boot Altyapisi (Min Kriter #2):
    - sw/bootloader/bootloader.S: immutable Boot ROM kodu (92 byte, 23 talimat)
    Flash'tan QSPI uzerinden firmware'i Instr SRAM'e yukler, 0x10000'e ziplar
    - soc_top: BOOT_ADDR parametresi (default 0x00000000 = Boot ROM)
    - teknotest_wrapper: BOOT_ADD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
    [boot_flow_test_tb.sv, helloworld.c, soc_top.sv, spi_flash_model.sv, teknotest_tb.sv, teknotest_tb_user_code.sv]
2026-06-08 ai_accelerator: gercek TFLite per-channel quantization
    - INPUT_ZP, CONV_OUT_ZP, FC_OUT_ZP eklendi (extract_weights.py)
    - M_CONV_Q31[8] + SHIFT_CONV[8]: per-channel CONV requant
    - M_FC_Q31 + SHIFT_FC: per-tensor FC requant
    - tflite_requant(): standart MultiplyByQuantizedMultiplier
    - MAC inputs: (input - input_zp) zero-point subtraction
    - SAME padding INPUT_ZP kullaniyor (TFLite kurali)
    - mac_a 16-bit (zero-point subtraction icin)
    - requant_relu/requant_no_relu silindi
    - Drain cycle'lar korundu (off-by-one bug fix)
    [ai_accelerator.sv]
2026-06-10 feat(periph): I2C Master (AXI4-Lite, Sartname EK-2) + standalone TB
    RTL:
    - i2c_master_axil.sv: EK-2 yazmac seti (NBY/ADR/RDR/TDR/CFG), sabit
    400 kHz SCL (50 MHz'de 124 clk ~ 403 kHz), NBY yuvarlama (0->1, >4->4),
    LSB-once bayt sirasi, TX>RX oncelik, CFG[4] NACK bayragi (takim tanimli)
    - periph_decoder.sv: 0x4000_0400 slotu aktif (AW/W/AR/B/R tum yollar)
    - soc_top.sv: i_i2c instance (bolum 12), CLK_FREQ_HZ parametresi,
    3 yeni port: i2c_scl_o, i2c_sda_oe_o, i2c_sda_i
    - soc_files.f: i2c_master_axil.sv eklendi
    Dogrulama:
    - verif/tb/i2c_master_tb.sv: self-checking standalone TB, davranissal
    I2C slave modeli, 22/22 PASS (Verilator 5.046, --binary --timing)
    - SCL periyot olcumu: 124 clk @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
2026-06-10 i2c testleri eklendi. Makefile düzenlemeleri yapıldı.
2026-06-12 feat: UART_1 stream + fpga_top (Genesys2) + entegrasyon guncellemeleri
    - uart_stream_axil.sv + uart_stream_tb.sv: AI veri akisi icin UART stream
    - fpga_top.sv + fpga/ + xilinx_prims_stub.sv: Genesys2 FPGA ust seviyesi
    - soc_top / periph_decoder / soc_files.f / Makefile: yeni birim entegrasyonu
    - TB ve SVA bind guncellemeleri (boot_flow, i2c_system, qspi_modes, sim_main)
    - repo temizligi: Zone.Identifier artiklari kaldirildi, .gitignore kurali
2026-06-14 fpga: Genesys2 bitstream akisi + QSPI okuma kenar fix'i (gercek donanim)
    QSPI MASTER FIX (kritik): qspi_master_axil SPI_DATA_RX okuma verisini DUSEN
    kenarda ornekliyordu; sim modeli standart-disi (yukselen-surme) oldugu icin
    sim geciyordu ama gercek S25FL256S (mode-0, dusen-kenar surme) ile tCO yuzunden
    1 bit kayiyordu (0x00012117 -> 0x8080900B). YUKSELEN kenarda ornekleyecek sekilde
    duzeltildi. Verilator: make boot PASS + make qspi-modes PASS. Genesys2'de
    flash-boot -> 'Hello World' dogrulandi.
    - fpga/build_genesys2.tcl: Vivado 2021.2 build (soc_files.f parse, global include,
    latch-regfile haric, UNC->W: cevirme, build C:'ye); BOOT_ADDR generic
    - fpga/flash_firmware.tcl: tek komut flash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
    [fpga_top.sv, hello_blink.c, led_only.c, qspi_hw_debug.c, qspi_master_axil.sv]
2026-06-15 README de düzeltme
2026-06-15 feat: FPGA build akisi + DTR gorselleri/scriptleri + RTL/sw guncellemeleri
    - fpga/ -> rtl/fpga/ tasindi (xdc, build, flash tcl)
    - RTL: i2c/uart_stream/ai_accel/bus entegrasyon guncellendi
    - sw: bootloader, ai_model, testler guncellendi
    - teknotest/ user_files degisti
2026-06-15 Refactor UART hello world program
2026-07-20 functional coverage + UART_CFG[0] auto-clear, arch-test/isa-compliance duzeltmeleri
2026-07-22 timer_irq_test + uart_stp_reg_test; irq16 ISR, ölü timer dali silindi, coverage listesi ve annotate eşiği güncellendi
2026-07-22 verif: timer/stp/strm testleri, stream DMA deadlock fix, coverage 65.5/73.0, irq covergroup 3/3; asic on hazirlik (.f + asic_top + sdc)
    [asic_top.sv, sim_main.cpp, uart1_strm_test.c, uart_stream_axil.sv]
2026-08-03 asic: SRAM makro entegrasyonu (23 x 32x512, ikili mod), boot ROM case ROM'a cevrildi; bellek 410336 -> 25312 bit; slang elaborasyon kapisi + envanter
2026-08-03 verif: coverage iki seviyeye ayrildi - SoC (67.2/79.5, sabit payda, dogrulama altyapisi haric) + modul bazli TB raporu (make coverage-tb); qspi %72.1, ai %96.1, i2c %97.8
2026-08-03 asic: gpio_axil LibreLane config, uart MIT lisansi, elab script portable
2026-08-03 qspi: rx_word_acc 32 -> 24 bit ve okuyan erisilemez default dali kaldirildi (sentezde 'used but has no driver' uyarisi)
2026-08-06 timing: iki yapisal darbogaz kapatildi - setup ihlali 914 -> 115
    1) SRAM okuma verisi yarim cevrimde kaliyordu.
    sky130 makrosunun .lib'inde dout0/dout1 timing_type = falling_edge;
    veri cevrimin ortasinda gecerli oluyor, tuketiciye periyodun yarisi
    kaliyor (butce 10 ns, olculen ihtiyac 13,1 ns). Makro hizli (0,53 ns
    erisim) - sorun tamamen kenar secimi, config ile cozulemez.
    axi_sram_wrapper'a REG_RDATA parametresi eklendi (varsayilan kapali),
    i_ai_sram ve i_data_sram'de acildi. r_valid ve ar_ready da birlikte
    kaydirildi; aksi halde tuketici veriyi bir cevrim erken okurdu.
    i_instr_sram'de acilmadi - ihlal uretmiyor.
    2) tflite_requant tek cevrimde cok is yapiyordu.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
2026-08-06 sw: cok sinifli demo firmware'i + UART'tan oznitelik vektoru yukleme
    ai_multi_class_test.c - 4 sinif tek bitstream'de. AI SRAM'in bos
    kuyruguna 3 ek vektor yerlestiriliyor (generate_ai_sram_init_multi.py),
    firmware her turdan once secileni 0x0'a kopyalayip argmax'i beklenen
    degerle karsilastiriyor. Her turda sonuc alanina 0xDEADBEEF sentineli
    yaziliyor; hizlandirici yazmadiysa test sessizce gecmiyor.
    Golden dizge yalniz 4/4 gectiginde basiliyor.
    ai_uart_load_test.c + send_vector.py - TEKNOFEST test verisini sahada
    verecek, girdi vektorleri bitstream'e gomulu kalamaz. Protokol
    FORMATTAN BAGIMSIZ: ham bayt tasir, uzunluk baslikta gelir, saglama
    ile dogrulanir. Boylece juri hangi formati verir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
    [ai_multi_class_test.c, ai_uart_load_test.c, generate_ai_sram_init_multi.py, send_vector.py]
2026-08-06 verif: sahte PASS kapilari kapatildi (K15) - golden dizge yalniz basari dalinda; ai_micro_speech TIMEOUT dalindaki basim kaldirildi, gpio/isa duzeltildi, uart_add_test'e self-check eklendi; kasitli b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
2026-08-06 verif: ai_accel_tb CSR el sikismasi Verilator surumunden bagimsiz hale getirildi (K14) - surme/birakma ve ornekleme negedge'de, transfer arada gecen posedge'de; 5.049'da davranis degismedi (6/6 PASS)
2026-08-06 verif: uart_stp_tb AXI4-Lite el sikismasi negedge tabanli hale getirildi
2026-08-07 verif: arch-test gercek imza kapisina tasindi - sahte PC>10 olcutu kaldirildi. DUT imza bolgesi (+SIG_START/+SIG_END/+SIG_FILE) dokuluyor ve spike referansiyla diff'leniyor; tohost yazma kontrolu iki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
    [sim_main.cpp]
2026-08-07 verif: fonksiyonel kapsama artik raporlaniyor. verif/sva/*_func_cov.sv sayaclari zaten kosuyordu ama toplanmiyordu; birlesim alan toplayici eklendi - her test farkli bin alt kumesini uyardigi icin ko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
2026-08-09 sw: link.ld .srodata/.sdata/.sbss toplamiyordu - sessiz veri kaybi
    GCC kucuk salt-okunur nesneleri gp-goreli erisim icin .srodata'ya koyar.
    link.ld yalnizca *(.rodata*) topluyordu, dolayisiyla .srodata bellege HIC
    yuklenmiyordu.
    Kanit: ai_uart_load_test.c'deki static const MAGIC[4] 0x2032C'ye (.srodata)
    dustu; data_mem.hex 203 word = 812 B uretiyordu, yani .rodata'nin sonunda
    kesiliyordu. Firmware MAGIC'i 0x00 olarak goruyordu.
    Neden bugune kadar sessiz kaldi: MAGIC[0] gibi sabit indisli erisimi
    derleyici immediate'a katliyor ve dogru calisiyor; yalniz MAGIC[matched]
    gibi degisken indisli erisim bellege gidiyor ve sifir donuyor. Ayni kaynak
    satirinda iki dal farkli davraniyordu.
    DONANIMDA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
    [ai_uart_load_test.c, check_ai_sram.py, make_uart_frame.py, sim_main.cpp]
2026-08-09 send_vector: --frame ile hazir cerceveyi aynen gonder, 8 bayt 0xFF onek, --dry-run ile kart olmadan dogrulama. Onek gerekli cunku kartta host baglanirken hatta cop olusur ve ilk baytlar kaybolur - si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
    [send_vector.py]
2026-08-09 verif+asic: kapsama olcum hatasi ve depo ici celiskiler. (1) Ayri TB kosumlari verif/coverage_waivers.vlt almiyordu; qspi-modes ve i2c-sys -f soc_files.f kullandigi icin tum CV32E40P vendor agaci ens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
2026-08-09 verif: qspi-err golden dizgesini test dosyasiyla ayni commit'e al + TB birlestirmesini geri al. (1) 249793b'de Makefile'a 'gecen=25' golden dizgesi girdi ama onu ureten 25. kontrolu (CCR geri okuma, 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
    [qspi_fifo_err_test.c]
2026-08-10 asic: config.yaml + makro gorunumleri depoya (Ip-3)
    Tum yollar goreli, EXTRA_GDS/PDN_MULTILAYER 3.0.6 adlarina gecti.
    Dogrulandi: sentez 27 SRAM makrosuyla temiz (26x2KB + 1x1KB).
    [macro_placement.cfg]
2026-08-10 asic: IP-4 - Makefile(asic_run/verify/clean), filelist.f (config'den uretilir), constraints/design.sdc, toplama/dogrulama betikleri, README 9.3-9.6, THIRD_PARTY LibreLane pin
2026-08-11 asic: dondurma adayi - genis kanal + kose-kosullu derate
    Olculdu (RUN_2026-08-11_01-08-11): route DRC 0, KLayout 0, LVS 0, XOR 0.
    SDC baglandi; derate kose-bazli (TT 1.0 / SS 2.661 / FF early 0.5),
    asenkron girisler false path.
    [macro_placement.cfg]
2026-08-11 K11 demo firmware v0: QSPI boot + IRQ'lu canli HW cikarim + UART menu (h/v/r) + LED; imaj: fw 1328B + veri 508B + YZ 30720B
2026-08-12 fpga: M3 bitstream yeni bootrom'la yeniden uretildi (WNS +2.455 / WHS +0.090, 50 MHz)
2026-08-12 fpga: sentezde BOOTROM_CONTENT tanimlanmiyordu - bootrom bitstream'de bos sentezleniyordu, M3 kart sessizliginin koku (13 Agu)
2026-08-13 test-all: soc-timer + soc-strm (zorunlu cevre birimi kanitlari, ikisi de PASS); make help bugunun hedef setiyle yenilendi; isterler karsilama matrisi
    [spi_flash_model.sv]
2026-08-13 UART surucu: uart_getc RX bayragini temizler (uart_axil.sv:197; art arda okuma ayni bayti donduruyordu, demo menusunu kartta kilitleyecekti); demo 'v' BLG1 cercevesine gecti (send_vector.py ile bireb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
2026-08-13 kurul-senaryo monitoru (sartname 5.2/1 hazirligi): UART komut kabugu - r/w/d peek-poke-dump + a AI cikarimi (irq17+mcycle); final gunu dis senaryolara dakikalar icinde uyum araci
2026-08-14 kart_sweep: juri UART provasi araci (BLG1) + 60/60 rastgele vektor raporu; demo imaji Berkin'in BLG1 demosuyla yeniden uretildi
2026-08-14 uart_putc RX bayragini imha ediyordu (her karakterde CFG bit1=0) - korunuyor; send_vector.py el sikisma bekliyor; UART protokolu belgelendi (RX FIFO yok)
2026-08-14 asic README: tum sayisal beyanlar nihai kosudan senkronlandi (RUN_teslim_2026-08-14); 9.11 tablosuna anten/TNS/PDN/baglantisiz-pin satirlari eklendi; 9.3 sure 3sa28dk; 9.9/7 ff min-path takibi kapati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
2026-08-16 asic_verify: DDK zorunlulari tamamlandi - versions.txt, stat/latch.rpt, magic.lyrdb, klayout.json, lvs.json, routing *.drc, power net-*.csv ve kose basina 14 STA raporu
2026-08-16 asic: blocks/gpio_axil kaldirildi - tek-blok deneme konfigurasyonuydu, nihai akista kullanilmiyor ve Tablo 8'de yeri yok
2026-08-16 hijyen: kaynakcada 4 bozuk URL duzeltildi (birlesmis 6/7 maddesi ayrildi); THIRD_PARTY'de son TBD kapatildi - arch-test icin dogrulanabilir surum izi
2026-08-16 guard: reports/ de taraniyor - reports/power/net-*.csv 137 MB ve yalniz results/ tarandiginda limite takiliyordu
2026-08-16 asic: RUN_teslim_2026-08-14 nihai kosu raporlari ve ciktilari (DDK Bolum 5/6)
    [metrics.csv, wire_lengths.csv]
2026-08-16 README 9.11: baglantisiz pin 880 siniflandirmasi (27x dout0 + gpio_in_i[31:16]) ve max cap/slew kose satirlari - beyanlar script ciktilariyla hizali
2026-08-17 blogic_balporsugu gorseli eklendi ve README duzenlendi
    images/blogic_balporsugu_img.png eklendi; README'de icindekiler
    tablosunun hemen ustune ortalanmis olarak yerlestirildi.
2026-08-17 asic: 55-bulguluk beyan denetiminin duzeltmeleri - lint 230 (log'dan yeniden sayildi), SS 34,4 tekil, core 17,74 mm2, hold 111+1 dagilimi, 9.9/4 basligi kapandi, 9.9/8 DDK kararlari, 9.1 port tablosu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
    [macro_placement.cfg]
2026-08-27 docs: README 10.8 kapsam raporu 27.08 temiz kosuya guncellendi; regression satiri 6-test
    - make regression aciklamasi 4-test -> 6-test (Spike lockstep minimal + deep), scripts/run_regression.sh ile uyumlu
    - 10.8 SoC kapsam: satir 72,2 (275/381), dal 84,2 (717/852), annotation 82,0 (1448/1764)
    - modul tablosu: boot 31/31, ai 404/418 (96,7), qspi-modes 226/311 (72,7)
    - fonksiyonel kapsama: 20/22 bin (UART 5/7, QSPI 7/7, AI-CSR 5/5, IRQ 3/3); UART auto-clear 4309 kontrol / 0 ihlal
    - kosu damgasi eklendi: 2026-08-27, Verilator 5.049, Spike etkin
2026-09-01 verif: UVM 4 bloga genisletildi (Timer/UART_0/I2C ref-modelli scoreboard + NACK/auto-clear directed testleri); 8/8 PASS
2026-09-01 verif: 4 hedefli C testi ile SoC kapsamasi %72,2->%91,1 (i2c-soc, qspi okuma yollari, negatif CSR, AI doyum); kalan satirlar A/B siniflandirmali; blok-TB ve perf ozetleri taze kosumlarla yenilendi
2026-09-01 asic: makro modelleriyle islevsel dogrulama (asic-sram-sim + asic-top-sim)
    - asic-sram-sim: boot akisi teslim edilen OpenRAM modelleriyle (DDK 1.3) - PASS
    - asic-top-sim: tam-yigin GDS-esdegeri kosu; asic_top ilk kez simule edildi,
    27 makronun tamami (ic input/conv_w/conv_out dahil) islevsel egzersiz - PASS
    - Known issue FC-1 deklare edildi: FC co_rdata'yi >=3 cevrim gec tuketiyor,
    model dout-X sozlesmesini ihlal (RTL ve imzali kosu DEGISTIRILMEDI)
    - README + asic/README + Makefile guncel
    [ai_boot_macro_test.c, asic_top_boot_tb.sv]
2026-09-01 docs: gorsel kanit paketi - guc kirilimi grafigi, kose basina setup slack histogrami, GDS zoom render'lari (9.7/9.10/9.11), kapsama ozeti grafigi (10.8); hepsi teslim raporlarindan uretiliyor, script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
2026-09-01 duzeltme: coverage_chart olu sorted satiri kaldirildi; 9.11 'decap/fill devices' -> 'decap devices' (denetci notlari)
2026-09-01 deneme/jtag: calisma plani ve koruma raylari - 3 gunluk kutu, go/no-go, main'e merge yok, kosular VM'de
2026-09-01 ai: FC-1 duzeltmesi - ST_FC_FETCH_W_WAIT boyunca co_re ayni adresle surulur
    Teslim edilen OpenRAM modeli dout'u okumayi izleyen posedge'de X'ler; FC
    asamasi conv_out okumasini mem_done'a bagli olarak >=3 cevrim gec
    tuketiyordu (main: asic/README 9.5 "Known issue FC-1"). Bekleme boyunca
    yeniden okuyunca ST_FC_MAC daima T+1 verisi tuketir; davranissal dalda
    ayni adresin tekrar okunmasi sonucu degistirmez.
    Kanit: make asic-top-sim, argmax kontrolu YENIDEN ACIK -> PASS
    (asic_top + 27 makro modeli, conv bit-tam VE argmax==2).
    Yalniz deneme/jtag dali; imzali ASIC kosusu ve main degismedi.
    [ai_accelerator.sv, ai_boot_macro_test.c, asic_top_boot_tb.sv]
2026-09-01 soc: i2c_sda_i girisine 2FF senkronizator (asic/README 9.9/3 notu)
    Asenkron SDA pad girisi gpio_in_i ile ayni desene esitlendi. Reset degeri
    1'b1 (SDA bosta pull-up; 0'la baslamak SCL yuksekken sahte START gibi
    gorunurdu). +2 cevrim (40 ns) I2C bit suresi yaninda ihmal edilebilir.
    Kanit: make i2c-sys PASS; make sim FW_SRC=sw/tests/i2c_soc_test.c PASS;
    yamali/yamasiz A/B diag farki yok.
    [soc_top.sv]
2026-09-01 debug: OpenOCD remote_bitbang koprusu + ucdan-uca demo (Gun 2) - PASS
    - rtl/debug/tb/jtag_dpi.cpp: SimJTAG icin DPI-C jtag_tick (extern "C");
    vendor remote_bitbang.c sarilir, non-blocking accept/recv -> OpenOCD
    bosta iken simulasyon ilerler (vendor sim_jtag.c busy-wait ettigi icin
    alinmadi).
    - verif/tb/jtag_openocd_tb.sv: soc_top + SimJTAG (TCP 9999), UART cozucu,
    'Q' -> exit -> $finish, 30 s sim bekci.
    - make jtag-openocd-build / jtag-openocd (scripts/run_jtag_openocd.sh):
    simi baslatir, portu bekler, openocd -f blogic_sim.cfg -f
    demo_halt_regs_mem.tcl kosar, VERDICT PASS/FAIL.
    - OpenOCD 0.12 demo PASS: tap 0x0b1061c1, hart XLEN=32 misa=0x40001104,
    halt, a0 0x12345678 yaz/geri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
    [jtag_bitbang_probe.py, jtag_openocd_tb.sv]
2026-09-02 debug: Gun 3 - ndmreset, tek-adim + donanim breakpoint, OpenOCD reset halt/bp, sertlestirme, kapsama
    - soc_top: sys_rst_n = rst_ni & ~ndmreset (JTAG_DEBUG); cekirdek/bus/cevre/
    bellek sarmalayicilari bu resete bagli, dm_top ve dmi_jtag rst_ni'de.
    Define yokken sys_rst_n = rst_ni (lint iki modda temiz, regression 6/6).
    - soc_axi_interconnect: DM penceresi 4 KB (addr[15:12]==0).
    - jtag_dpi.cpp: remote_bitbang yalniz loopback'e baglanir (127.0.0.1:9999).
    - jtag_smoke_tb 9 asama: +tek-adim (dcsr.step, cause=4), +donanim trigger
    (tselect/tdata1/tdata2, dpc==A cause=2), +ndmreset (allhavereset/ack,
    dpc==0x10000 cause=3, firmware bastan, UART 2. kez): make jtag-sim 9/9 PASS.
    - OpenOCD demo: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
    [jtag_openocd_tb.sv, jtag_smoke_tb.sv, soc_axi_interconnect.sv, soc_top.sv]
2026-09-02 demo panel: 1000-vektor olcegine saglamlastirma - zaman asiminda otomatik 1 tekrar, her sonuc aninda diske (anlik kayit dosyasi), ilerlemede kalan sure tahmini, log 3000 satirda budanir. Not: hiz dar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
    [juri_panel.py]
2026-09-02 scripts: vm_jtag_asic.sh / jtag_asic_config.py calistirilabilir (Windows'ta mod kaydedilmemisti, VM'de nohup Permission denied)
2026-09-03 asic/jtag TAM AKIS hazirligi: asic_top.sv JTAG pinleri (ifdef JTAG_DEBUG, tanim yokken birebir), jtag_asic_config.py 'full' config + design_jtag.sdc (jtag_tck 100 ns, asenkron grup, pin butceleri), v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
2026-09-03 jtag: test paketi 9 -> 17 asama, kopru birim TB'si, lint/esdegerlik/kapsam kapilari
    Kapsam incelemesinde bulunan 14 boslugun 13'u kapatildi (biri kart uzerinde).
    jtag_smoke_tb (17 asama): DMI busy + dtmcs.dmireset/dmihardreset, progbuf
    istisnasi (cmderr=3), cmderr=2/4 yollari, SBA tie-off, DM kesif/WARL/geri
    okuma, TAP kose durumlari (BYPASS, IR capture, Pause-DR), ISRAM'e JTAG'dan
    yazma + ebreak, DM bolgesi karakterizasyonu.
    Yeni: verif/tb/axi_dm_slave_tb.sv (yonlu birim TB, gercek dm_top ile 6/6;
    tahkim, r_ready/b_ready tutma, bayt-enable, ucusta reset), jtag-bridge-sim,
    jtag-lint, jtag-lint-fpga, jtag-equiv, jtag-cov, regression-jtag hedefleri.
    GERCEK BULGU (G-06): gdb demosunun kapani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
    [axi_dm_slave_tb.sv, jtag_openocd_tb.sv, jtag_smoke_tb.sv, xilinx_prim_stubs.sv]
2026-09-05 jtag: GERCEK KARTTA OpenOCD PASS (Genesys 2, 6 Eylul 2026) - JTAG donanimda kanitlandi
    Kart uzerindeki FT2232H usbipd ile WSL'e verildi, OpenOCD 0.12 (ftdi) FPGA'nin kendi
    TAP'i (0x43651093) uzerinden BSCANE2 USER3/USER4 tuneliyle riscv-dbg DTM'e ulasti.
    Flash'tan boot eden demo firmware'i uzerinde: halt (pc=0x000104fe), a0 yaz/oku
    0x12345678, step 0x104fe->0x10500 (+2), misa=0x40001104 (RV32IMC), mww/mdw 0x21000
    cafef00d 11223344 + 8 sozcuk blok, UART0 MMIO, resume/halt, HW BREAKPOINT vurdu,
    watchpoint beklendigi gibi reddedildi (veri tetikleyicisi yok), reset halt pc=0
    (boot ROM), reset run. OpenOCD cikis 0.
    Bulgu: Genesys 2'de JTAG, FT2232H'nin B kanalinda (ftdi channel 1); kanal 0 hep s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
2026-09-06 jtag: kartta JTAG + YZ cikarimi ENTEGRASYON testi PASS (6 Eylul 2026)
    scripts/kart_jtag_entegrasyon.py (Windows: COM7 + OpenOCD telnet 4444, JTAG WSL'de):
    0) JTAG ile DSRAM 0x20000 = firmware_flash.bin[0x8000] (flash veri bolgesi); ISRAM
    0x10000 veri-portu okumasi DSRAM'e yansiyor - belgeli sinir kartta gozlendi
    1) taban: yes_real -> yes, no_real -> no, 459062 cevrim
    2) halt (pc=0x104fa) + YZ CSR (CTRL=0 STATUS=0x30 DATA_ADDR=0x30000 OUT_ADDR=0x35a58)
    + DSRAM scratch yaz/oku + resume -> sonraki cikarim birebir ayni
    3) hw breakpoint @run_hw 0x1015a (adres committed flash imajinda kod baytlariyla
    dogrulandi): vektor UART'tan gelip saglamasi gecince, cikarim BASLAMADAN cekirdek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
    [kart_jtag_entegrasyon.py]
2026-09-06 birlestirme hazirligi: FC-1 ve i2c 2FF tanim arkasina - tanimsiz derleme main ile BIREBIR
    FC1_FIX (ai_accelerator.sv ST_FC_FETCH_W_WAIT co_re) ve I2C_SDA_SYNC (soc_top.sv
    i2c_sda_i 2FF) artik `ifdef arkasinda, varsayilan KAPALI. Boylece teslim kosusu
    RUN_teslim_2026-08-14 main'in varsayilan RTL'ini temsil etmeye devam eder; asic/README
    9.5 "declared, NOT patched" ve 9.9/3 beyanlari teslim icin dogru kalir.
    JTAG derlemelerinin tamami (make jtag-sim/openocd-build/lint/lint-fpga/regression-jtag,
    jtag_elab_check.sh, jtag_asic_config.py, build_genesys2_jtag.tcl) uc tanimi birlikte
    acar -> olculen JTAG varyanti (v1/v2/v3 kosulari, kart bitstream'i) degismedi.
    jtag-equiv: eski beklenti (13 satir)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
2026-09-06 asic: JTAG debug altsistemi teslim yapilandirmasina alindi - config.yaml/filelist.f'e riscv-dbg + axi_dm_slave kaynaklari, JTAG_DEBUG/FC1_FIX/I2C_SDA_SYNC tanimlari, v1.38.0 common_cells include; des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
2026-09-06 JTAG teslim yapilandirmasina alindi: derleme sistemi, TB'ler, FPGA, betikler, lisanslar
    - soc_files.f: JTAG_DEBUG/FC1_FIX/I2C_SDA_SYNC +define satirlari + riscv-dbg kaynaklari (tek kaynak); tum sim hedefleri JTAG'li derler
    - Makefile: test-all 18 bilesen (jtag-sim, jtag-bridge-sim); asic-top-sim argmax kontrollu (FC-1 duzeltmesinin kaniti; negatif kontrol FAIL); lint = teslim yapilandirmasi; yeni lint-fpga; jtag-gates yeniden; regression-jtag / jtag-lint / jtag-lint-fpga / asic-top-sim-fc1fix kaldirildi; Makefile.verilator -Wno-UNOPTFLAT
    - TB'ler: soc_top/asic_top orneklerinde JTAG TAP tie-off (trst_n=0)
    - FPGA: build_genesys2.tcl soc_files.f'ten tanimlari okur, dmi_jtag_tap -> dmi_bscane_ta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
    [ai_accelerator.sv, ai_boot_macro_test.c, asic_top.sv, asic_top_boot_tb.sv, axi_dm_slave_tb.sv, boot_flow_test_tb.sv, fpga_top.sv, genesys2.xdc]
2026-09-06 asic: RUN_final_2026-09-06 teslim ciktilari - JTAG'li teslim yapilandirmasinin resmi kosusu (VM1, taze klon 248069b, LibreLane 3.0.6 Classic, 78/78, 3 sa 28 dk): TT +1.684 / SS -10.537 / FF +4.010 ns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
    [metrics.csv, wire_lengths.csv]
2026-09-06 fpga+demo: kart ustu OLED'de sinif/cevrim/baud, switch'lerle UART baud secimi (demo firmware v1)
    - rtl/fpga_top.sv + genesys2.xdc: 128x32 SSD1306 OLED pinleri (Digilent Genesys-2-Master.xdc), GPIO ODR[15:10]'dan surulur; VDD/VBAT guc anahtarlari aktif-dusuk oldugundan evrilir (reset sonrasi besleme kapali, guc sirasi firmware'de)
    - sw/demo/demo_main.c: bit-bang SPI SSD1306 surucusu (Digilent OledInit sirasi), 5x7 yazi tipi (oled_font.h, ASCII-art'tan uretildi), 4 satir: baslik / sinif / HW cycle / baud; baud secimi GPIO IDR[1:0]: sw0 = 9600, sw1 = 115200, ikisi asagi = 115200, ikisi yukari = gecersiz (son ayar korunur, LED7 + OLED uyarisi); acilista ve bosta okunur, degisince yeni hizda bann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
    [demo_main.c, fpga_top.sv, genesys2.xdc, juri_panel.py, kart_jtag_entegrasyon.py, oled_font.h]
2026-09-06 demo: OLED yonelim komutlari Digilent Genesys-2-OLED demosuyla birebir (A0/C0/DA 00); sim_main'e +GPIO_LOG izi
    - Digilent'in resmi Genesys 2 OLED demosunun init ROM'u (init_sequence.coe) cozuldu: VDD=0 / VBAT=0 pinde besleme ACIK (aktif-dusuk; fpga_top'taki evirme dogru), sira VDD -> 1 ms -> AE -> RES 0/1 -> 8D 14 D9 F1 -> VBAT -> 100 ms -> 81 xx -> A0 -> C0 -> DA 00 -> AF. Firmware ayni yonelim/COM komutlarini kullanir (onceki A1/C8/DA 20 PmodOLED esdegeri yerine)
    - verif/tb/sim_main.cpp: +GPIO_LOG=<dosya> ile gpio_out_o her degisimde loglanir; demo firmware'in OLED SPI akisi Verilator'da cozuldu: VDD @178 cevrim, RES @100238, VBAT @151257, komutlar AE 8D 14 D9 F1 | 81 8F A0 C0 DA 00 AF | B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
2026-09-06 demo: UART/OLED ve juri paneli metinleri Ingilizce; ayristiricilar yeni bicime gecti; panel .hex yukleyicisi cok vektorlu
    - demo_main.c: banner "Micro Speech live demo", sonuc satiri "class = <ad> HW cycle = <n> speedup ~x.yx (SW baseline 9,684,726)", el sikisma "waiting for BLG1 frame", menu/rapor/uyari satirlari ve OLED satirlari (class / HW cycle / UART: ... [sw0|sw1|def] / SW0+SW1 ERROR) Ingilizce; mantik/bit haritasi/gecikmeler ayni; run_hw 0x104b8 degismedi; firmware_flash.bin yeniden (5252 B .text)
    - juri_panel.py: tum arayuz, log, messagebox, dosya basliklari Ingilizce ("Load bitstream...", "Connect / Test", "Select jury file...", "RUN ALL", "BOARD >"); cevap ayristirma "class =" /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
    [demo_main.c, juri_panel.py, kart_jtag_entegrasyon.py, kart_sweep.py, send_vector.py]
2026-09-06 panel: rastgele N vektor taramasi (RANDOM SWEEP) + aktarim stres/negatif testleri (STRESS TESTS) + kartsiz FakeSerial selftest
    - RANDOM SWEEP: kart_sweep.py ile ayni ornek uretimi (run_accuracy_window.make_samples, seed 31082026, 40 cekirdek + uzatma ailesi) ve ayni bit-exact SW referansi (run_model); N=1000 varsayilan, parcali gonderim (chunk/gap), canli log ve buyuk etiket, ozet + juri_sonuclar_sweep_<tarih>.txt raporu
    - STRESS TESTS a-g: 64 B/5 ms ve 1 B/1 ms parcali aktarim, sihir oncesi 64 bayt cop, bozuk saglama (CHECKSUM ERROR beklenir, class satiri gelmez), gecersiz uzunluk 1961, kesik cerceve (RX timeout, sonra toparlanma), 20 vektor ardarda throughput
    - Kart sinifi: ham_gonder/v_ba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
    [juri_panel.py]
2026-09-06 panel: dogrulama paketi - 39 make hedefi tablodan secilip WSL icinde kosar, canli log, satir basina PASS/FAIL, juri_make raporu; make test-full (yerel her sey tek komut); make help eksik 8 hedef
    [juri_panel.py]
2026-09-06 panel: dogrulama paketi okunur rapor - her hedef icin uzun aciklama (39), PASS/FAIL karar satirlari, kosu sonunda bildirim penceresi ve aciklamali rapor dosyasi; log icin Clear/Save dugmeleri
    [juri_panel.py]
2026-09-06 docs: FPGA gorselleri teslim dcp'sinden (12.4 timing summary, 12.5 yerlesim+yonlendirme, 12.5.1 fpga_top/i_soc sematikleri); ASIC: guc sebekesi ve fill hucreleri gizli temiz die render (asic/scripts/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
2026-09-06 kapilar: jtag-openocd/jtag-gdb bayat sim ikilisini yeniden derliyor; jtag-equiv beklenen diff fpga_top OLED pinleriyle yeniden temellendi; panel aciklamalari
    Panelden kosulan 5 FAIL'in kok nedenleri ve duzeltmeler:
    - jtag-openocd (run=0): kosucu ikiliyi yalniz YOKSA derliyordu; ~/blogic-mcu'daki
    obj_dir_jtag_ocd/jtag_openocd_sim 2 Eylul tarihliydi (TB'nin 58 karakterlik
    eski UART cozucusu + eski DM/kopru RTL'i) -> 'reset run' sonrasi ucuncu
    selamlama loga hic dusmedi. Yeni scripts/jtag_sim_stale.sh: kaynaklardan
    (soc_files.f, rtl/, TB, firmware, bootrom) biri ikiliden yeniyse
    jtag-openocd-build kosar; run_jtag_openocd.sh ve run_jtag_gdb.sh kullanir.
    Yeniden derlenince jtag-openo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
    [juri_panel.py]
2026-09-06 panel: uc sekme (Board demo / Verification suite (make) / Questa waves), log ortak. Questa waves: verif/questa'nin 21 testi tabloda; secilen test Questa GUI'sinde hazir dalga penceresiyle acilir - yu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
2026-09-06 panel: dogrulama paketi WSL komutu duzeltildi - 'wsl.exe --' betigi oturum kabugundan (zsh) gecirip kacisli tirnaklari bozuyordu (tr: extra operand; 39 hedef 0:00'da sahte PASS, 6 Eylul). Simdi 'wsl.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
    [juri_panel.py]
2026-09-06 asic-elab kapisi yerelde de kosuyor: (1) nix profil dizinleri PATH basina (etkilesimsiz kabukta LibreLane bulunamiyordu), (2) asic/filelist.f CRLF -> LF ve betikte CR temizligi (read_slang no input f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
2026-09-07 docs: 12.1 kart gorseli 7 Eylul fotografiyla degistirildi (teslim bitstream, OLED + LED, yataya cevrildi); 13.7'ye tum katmanli KLayout render'i (guc sebekesi gorunur) guc sebekesiz render'in yanina 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
2026-09-07 docs 10.7: I2C terminal yakalamasi - make i2c-sys 7 Eylul kosusu (TEST SUCCESS, I2C AXI-Lite denetleyici 3758/3758, [I2C-SYS] PASS); yer tutucu kapandi
2026-09-07 TEKNOFEST demo juri araci (demo_harness.py 1.0.2) icin iki-UART akisi: demo firmware v2 - UART1 (Pmod JA) stream cercevesi BLG1+len16+1960 int8+CRC16-CCITT, core UART0'da 'RESULT: <sinif>' satiri, ke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
2026-09-07 demo firmware v2: 'l' UART1 loopback oz-testi (JA1-JA2 jumper ile adaptorsuz kart testi: firmware kendi cercevesini UART1 TX'ten yollar, RX'ten alip RESULT basar), -Os (.text 8,6 KB -> 4,4 KB, 8 KB I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
2026-09-07 kart kaniti: TEKNOFEST juri araci (demo_harness.py 1.0.2) Genesys 2'de - public dataset 156/156 golden uyumu, 0 timeout, saglamlik 11/11, gecikme ~43 ms (8 Eylul 00:53, CP2102 Pmod JA + FT232); rapor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
    [robustness.csv, samples.csv]
2026-09-07 demo harness: juri araci biciminde rastgele regresyon seti + GUI denemesi + sim hedefi
    - sw/demo/make_harness_dataset.py (make demo-harness-dataset DS_N/DS_SEED/DS_OUT): kart_sweep.py /
    panel RANDOM SWEEP ureteci (40 adli aile + 8 aileli tohumlu uzatma) + bit-exact SW referansi ->
    aracin kendi yerlesimi manifest.csv + vectors/*.bin + dataset_summary.json (1000 vektor 52 s,
    numpy/tflite yok). Aracin README'sindeki "kendi verinle ek test" onerisi; arac dry-run 40/40 kabul etti.
    - harness_frames.py sim --manifest/--count: bu setten tohumlu K vektoru UART1 stream yoluna surer;
    make demo-harness-sim-dataset (DS_K=10) RESULT satirlarini manifest golden sutunuyla karsilastirir.
    - demo_gui.p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
2026-09-08 demo harness: rastgele set kartta 200/200, 0 timeout, 11/11 (8 Eylul 03:05) - rapor seti + manifest repoda
    - sw/demo/harness_results/2026-09-08_random_dataset_n200/: report.md, summary.json, samples.csv, robustness.csv,
    transcript.log, config_used.json + kosulan setin manifest.csv ve dataset_summary.json (seed 31082026, 1000 vektor,
    arac -n 200 ile 200'unu secti). Gecikme medyan 43,28 ms, team id 772759.
    - README 12.6 satirina kart sonucu; checklist durum satiri ve sorun tablosuna saha tanisi: butun vektorler timeout
    ama banner geliyorsa COM7'ye 'r' -> rx-bytes=0 kabloya bayt gelmiyor (03:01 provasinda adaptor JB'ye takiliydi,
    JA olmali), rx-bytes>0 + bad-crc -> sw2/ICD hiz uyumsuz.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
    [manifest.csv, robustness.csv, samples.csv]
2026-09-08 README: periph_decoder agac yorumu 8 -> 7 AXI4-Lite slave (RTL ve 4. bolumle tutarli: UART_0, GPIO, Timer, UART_1, I2C, QSPI, AI CSR)
2026-09-08 kart kaniti: juri araci ile 2000 vektorluk rastgele set 2000/2000 golden uyumu, 0 timeout, 11/11 saglamlik (8 Eylul 23:56)
    - sw/demo/harness_results/2026-09-08_random_dataset_n2000/: report.md, summary.json, samples.csv, robustness.csv,
    transcript.log, config_used.json + kosulan setin manifest.csv ve dataset_summary.json (seed 31082026, 2000 vektor,
    silence 27 / unknown 481 / yes 741 / no 751; uretim 88,6 s). Karisiklik matrisi tam kosegen, mismatch 0.
    - Gecikme medyan/p95/max 43,34 / 43,92 / 46,38 ms; tx medyan 166,78 ms; team id 772759.
    - 2000'lik set 1000'lik setin UST KUMESI: uretec tohumlu, --n buyutmek yalnizca sona ekliyor.
    - README 12.6 kendi regresyon seti satiri ve 13.8 signoff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
    [manifest.csv, robustness.csv, samples.csv]
2026-09-09 verif: kapsama ozeti 9 Eylul kosumuyla yenilendi - UART fonksiyonel bin 7/7, TOPLAM 22/22
    make coverage yeniden kosuldu (HEAD ed03fe2, ayni 15 C testi, ayni tek build,
    sabit payda). 6 Eylul olcumunden bu yana depoya giren firmware/test
    degisiklikleri UART sayacinin eksik kalan binini kapatti:
    UART 6/7 (86%) -> 7/7 (100%)
    TOPLAM 21/22 (95%) -> 22/22 (100%)
    auto-clear (EK-2 v1.3): 6432 -> 6694 kontrol, 0 ihlal (degismedi)
    Satir kapsamasi %90,7 (359/396) ve dal kapsamasi %88,6 (819/924) ayni kaldi;
    kapsanmamis satir dagilimi da degismedi. Sunumdaki kapsama slaytinin
    ekran goruntusu artik depodaki ozetle birebir.
2026-09-09 asic: RUN_hold035_2026-09-09 teslim ciktilari - hold onarimli kosunun reports/results/checksums agaci
    VM1, taze klon 248069b + 5 satirlik config farki (hold marji 0,35,
    ALLOW_SETUP_VIOS, SIGNOFF_SDC_FILE). Uc kosede setup ve hold kapali
    (37 ns imza: setup +9,718 / +0,197 / +12,185, hold +0,165 / +0,637 / +0,040,
    0 ihlal); hedef 20 ns STA'si reports/timing_target_20ns/ altinda
    (max.rpt.gz + sha256; min.rpt reports/timing ile ozdes oldugundan yok).
    Anten 2 ag / 2 pin (beyan, README 9.9/13), route DRC 0, KLayout DRC 0/257,
    LVS 0, XOR 0, PDN 0, Magic 9.201 nwell.4 (degismedi). Guc TT 64,0 mW
    @ 27 MHz (117,5 mW @ 50 MHz hedefi), transistor 12.750.459.
    config.yaml: hold onarimi ayarlari + SIGNOFF_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
    [metrics.csv, wire_lengths.csv]
2026-09-09 ASIC frekans duzeltmesi: "~32.7 MHz" geri cekildi, olculen 28.6 MHz
    Teslim kosusunun SS kosesi icin belgelerde gecen ~32.7 MHz iki ayri yoldan
    turetilmisti ve ikisi de bu tasarim icin gecersiz: (1) 20 ns'deki -10.537 ns
    slack'in dogrusal olceklenmesi, (2) OpenSTA report_clock_min_period
    (clock.rpt: fmax = 32.75) - bu komut makrodan baslayan yollari disliyor.
    Ikisi de ayni yanlis sayiya vardigi icin hata denetimden gecmisti.
    Olcum: yerlestirilmis-yonlendirilmis veritabanina HIC dokunmadan yalnizca
    OpenROAD.STAPostPNR adimi farkli create_clock periyotlariyla tekrar kosuldu
    (30/32/34 ns -> SS setup -2.502 / -1.502 / -0.502). Setup slack periyot
    basina 1.0 degil 0.5 ns kazaniyor; kapanis noktas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
2026-09-09 README: kapsama ve UVM ekran goruntusu yer tutuculari 9 Eylul kosum ciktilariyla kapatildi; 11.4'e N=1000 dogruluk penceresi kaniti eklendi
    Iki "placeholder - add screenshot" satiri gercek terminal ciktilariyla degistirildi;
    ucuncu gorsel EK-1 dogruluk penceresinin kanitini 11.4'e ekliyor.
    - images/coverage_terminal_20260909.png: make coverage - satir %90,7 (359/396),
    dal %88,6 (819/924), fonksiyonel kapsama 22/22 (UART 7/7, QSPI 7/7, AI-CSR 5/5,
    IRQ 3/3), EK-2 v1.3 CFG[0] auto-clear 6694 kontrol / 0 ihlal
    - images/uvm_regression_terminal_20260909.png: make uvm - 4 blok, 8 test,
    8 PASS / 0 FAIL, UVM_ERROR 0, UVM_FATAL 0
    - images/ai_accuracy_n1000_terminal_20260909.png: make ai-batch10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
2026-09-09 Kesif/plan belgeleri artik 6 Eylul kosusunu "teslim edilen cip" diye gostermiyor: teslim kosusu RUN_hold035_2026-09-09
    Dort belge, 9 Eylul'de degistirilen teslim kosusundan haberdar degildi ve
    RUN_final_2026-09-06'yi mevcut resmi kosu olarak sunuyordu. Bu, asic/README
    9.13'teki "belgeler ile teslim edilen raporlar celismez" kuralini ihlal
    ediyordu:
    - rtl/debug/asic_jtag_sentez/README.md: "teslim edilen cip = RUN_final" ->
    teslim RUN_hold035_2026-09-09; 6 Eylul kosusunun bu uc kesif kosusundan
    turedigi ve 9 Eylul'de superseded oldugu, farkin yalnizca resizer hold
    onarimi + ayri signoff SDC oldugu yazildi. "Official run facts" blogu
    6 Eylul icin tarihsel hale getirildi ve teslim kosus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
2026-09-09 asic/README 9.9/13: zorunlu kose kumesi disindaki parazitik kose duyarliligi olculdu ve beyan edildi
    Rakip bir takimin 9 kosede imzaladigini gorunce, elimizdeki min/max
    parazitik SPEF dosyalariyla (results/spef/min, results/spef/max) ayni
    veritabanini uc PVT x uc RC = dokuz kombinasyonda imzalama STA'sindan
    gecirdik. Tasarima dokunulmadi, yalnizca OpenROAD.STAPostPNR adimi
    genisletilmis STA_CORNERS ile tekrar kosuldu.
    Sonuc: dokuz kosenin yedisi temiz. Iki hucre ihlalli, ikisi de "max"
    (kotumser RC) satirinda: max_ss_100C_1v60'ta bir kurulum yolu -0,029 ns,
    max_ff_n40C_1v95'te yedi tutma yolu -0,054 ns. Onlarca pikosaniye
    mertebesinde ve iki kose de zorunlu kumede degil (Final Ciktilar Tabl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
2026-09-10 uvm: Verilator 5.052 + UVM 2020-3.1 gecisi, kisitli rastgele diziler (deneme/uvm)
    - verif/uvm-lib: verilator/uvm 795b5f2 (gecici cozumlu eski catal) ->
    656f20d = Accellera UVM 2020-3.1 (IEEE 1800.2-2020) + Verilator PLI eki;
    DEVIATIONS.md eklendi, NOTICE.txt ve KAYNAK.md guncellendi
    - Makefile.uvm: Verilator >= 5.052 surum kapisi (check_verilator); yol
    onceligi VERILATOR > ~/tools/verilator-5.052 > PATH; -Wno-CONSTRAINTIGN
    kaldirildi; I2C artik tam (line+toggle) kapsamayla derleniyor (5.049'daki
    toggle Internal Error yok); UVM paketi derleme onkosulu yapildi
    - periph_random_seq: adres ve veri randomize() + inside kisitiyla cozucuden
    geliyor; cozum basarisizligi ve havuz disi adre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
    [axi_lite_uvm_pkg.sv, periph_uvm_pkg.sv]
2026-09-10 uvm: DPI acik, rastgele testler uc tohumla, z3 kapisi (deneme/uvm)
    - DPI: UVM_NO_DPI kaldirildi; verif/uvm-lib/src/dpi/uvm_dpi.cc (656f20d'deki
    Verilator VPI arka ucu uvm_hdl_verilator.c dahil) --vpi ile derleniyor.
    UVM 2020-3.1'in her kosuda verdigi iki uyari (NO_DPI_USED, NO_VISIT_CHECK)
    kalkti; +UVM_TESTNAME DPI'dan okunuyor, bilesen adi denetimi calisiyor
    - Tohum taramasi: yonlendirilmis 4 test bir kez, rastgele 4 test UVM_SEEDS
    (varsayilan 1 2 3) ile +verilator+seed+N; 16 kosu. Tek tohumda UART ve I2C
    rastgele testleri birebir ayni akisi uretiyordu (UVM ad tabanli tohumlama)
    - z3: Verilator 5.052 kisitli rastgele icin z3 cozucusunu cagiriyor;
    check_verilator z3 yoksa acik me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
2026-09-10 uvm: rastgele testler kendi dizi adini kullaniyor, testler arasi ayni akis kalkti (deneme/uvm)
    - periph_random_seq her testte get_type_name() tabanli adla yaratiliyor
    (ornek: uart_random_test_seq); onceki ortak ad "seq" idi. UVM dizi
    tohumunu tip + tam ad + global tohumdan turettigi icin ayni tohumda
    timer, uart ve i2c rastgele testleri ayni yon ve veri akisini
    paylasiyordu. 8674e2d'deki tohum taramasi kosular arasi tekrari
    cozmustu; testler arasi aynilik bu commit ile kalkti.
    - Dogrulama: uc tohumun ucunde UART ve I2C islem akislari farkli.
    (8674e2d mesajinda oran satirlari bir onceki testin altina dusmustu;
    asagida her oran kendi rastgele testinin altinda.)
    Sonuc (make uvm):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
2026-09-10 verif: 10 Eylul kosum kanitlari (arch-test, UVM, kapsama, soc-ai-irq) ve 9 Eylul kapsama errata'si
    - verif/results/2026-09-10/arch_test: ozet (PASS 72, BILINEN_FARK 1, FAIL 0),
    test basina results.tsv, cebreak-01 ref/dut imzalari, diff ve md5.
    - verif/results/2026-09-10/uvm: temiz 10 testlik kosunun logu ve test loglari,
    z3'suz negatif kontrol logu.
    - verif/results/2026-09-10/coverage_summary.txt ve ai_irq_test sonucu.
    - verif/results/2026-09-09/ERRATA_coverage.md: o gunku 22/22 ve 6.694 kontrolun
    kirlenmis birlesimden geldigi; anlik goruntunun kendisi degistirilmedi.
    - images/*_20260910.png: README gorselleri, log metninden birebir render
    (ekran goruntusu degil, altyazida belirtildi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
    [results.tsv]
2026-09-10 Belgeler: sartname sapmalari ve 27,0 MHz etkileri beyan edildi, signoff metni sertlestirildi, 10 Eylul sonuclari islendi
    Denetimde bulunan ve hicbir yerde yazmayan maddeler, kaynaga karsi yeniden
    olculerek yazildi. RTL ve yapilandirma degerleri degismedi (asic/config.yaml ve
    SDC'lerde yalniz yorum satirlari).
    README:
    - 5.6 QSPI yazmac haritasi; 5.7 tek tabloda 12 sapma/sinirlama: UART_CFG[0]
    gonderimi baslatmiyor (TDR yazmasi baslatiyor), UART bolucu 8*floor(CPB/8),
    I2C SCL sentezde sabit, Timer 0xFFFFFFFF ornegi, QSPI SCLK = f/(2(PRE+1)),
    ulasilamayan '0001' hata kodu, S25FL256S ve test edilmeyen flash komutlari,
    donanimda Softmax yok, demo ISR'si UART'a yazmiyor, tek flop UART RX,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
2026-09-10 verif: Verilator 5.052 kanitlari (deneme/uvm) - test-full 9/9, UVM 20/20, kapsama dal %88,5
    - make test-full Verilator 5.052 ve z3 4.8.12 ile: test-all 18/18, lint,
    lint-fpga, jtag-gates, asic-sram-sim, asic-top-sim, boot-real,
    isa-compliance, ai-uart-load hepsi PASS. arch-test I/M/C: 72 PASS ve 1
    bilinen fark (main ile ayni). UVM: 20 kosu, 20 PASS.
    - verif/coverage_summary.txt 5.052 ile yenilendi: satir %90,7 (359/396) ve
    fonksiyonel 21/22 ayni; dal %88,5 (818/924; 5.049 ile %88,6, 819/924).
    obi_to_axi.sv kapsanmayan satir 24 (5.049 ile 23); hepsi siniflandirma
    belgesinin 3. bolumundeki araliklarda, sinif A. RTL degismedi.
    - verif/perf_summary.txt 5.052 ile yenilendi: cevrim say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
2026-09-12 verif/gls: teslim netlistinin TT SDF'li kapi seviyesi benzetimi - boot + YZ cikarimi 37 ns'de GECTI
    Simdiye kadar dinamik kanitimiz yalnizca RTL'di; yerlesim sonrasi zamanlama
    kaniti tek basina STA idi. Bu commit ucuncu kanit turunu ekliyor: teslim
    edilen RUN_hold035_2026-09-09 netlisti, teslim edilen TT SDF'i geri
    annote edilerek, dogrulanmis 37,000 ns periyotta Questa'da kosuldu.
    Sonuc (12 Eylul, verif/results/2026-09-12/gls/full_37ns_boot_ai.log.gz):
    - 124,823 ms'de bootloader bitti ve firmware komut SRAM'inden kosuyor ('R'),
    144,250 ms'de "Hello World!" - yani conv_out sagtoplami VE FC argmax altin
    modelle birebir; 3.898.641 cevrim.
    - 0 zamanlama denetimi ihlali. Questa ihlalleri Er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
    [asic_top_gls_tb.sv, sdf_msg_census.py, strip_fillers.py]
2026-09-12 asic: Bolum 6.2 signoff SDC'si teslim agacina eklendi; congestion, anten kapsami ve kapatilan ERROR_ON kapilari beyan edildi
    ASIC akisinin bagimsiz bir denetiminde (42 aday bulgu, 35'i elendi) ayakta
    kalan bes eksik. Hicbiri yeniden kosu gerektirmiyor; hepsi ya teslim agacina
    zaten var olan bir akis girdisinin kopyalanmasi ya da beyan.
    1) Bolum 6.2 PnR'de ve post-PnR STA'da kullanilan SDC'lerin IKISINI de
    results/sdc/ altinda istiyor. Bu kosuda ikisi farkli (20 ns / 37 ns) ama
    dizinde yalnizca OpenROAD'in geri yazdigi 20 ns'lik asic_top.sdc vardi;
    beyan edilen 27,0 MHz'i ureten dosya teslim agacinda gorunmuyordu.
    constraints/design.sdc ve design_signoff.sdc bayt-ayni kopyalarla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
2026-09-12 verif: UART stop biti 11 kodu SoC testinde - fonksiyonel kapsama 21/22 -> 22/22
    - sw/tests/uart_stp_reg_test.c: STP=3 fazi (gonderim + geri okuma). EK-2'de
    1X = 2 stop biti; 11 gecerli bir kod, ayrilmis degil. RTL yalniz STP[1]'e
    bakar; blok seviyesinde uart_stp_tb 11'i zaten 10 ile ayni olcuyordu.
    Eksik olan SoC seviyesindeki kullanimdi.
    - make coverage (Verilator 5.049): UART 7/7, TOPLAM 22/22, auto-clear 6410
    kontrol 0 ihlal; satir %90,7 ve dal %88,6 degismedi. uart_stp_reg_test
    PASS, STP=11 bininde 36 gonderim.
    - README 10.8 fonksiyonel kapsama paragrafi 22/22; 11 kodunun ayrilmis diye
    anilmasi duzeltildi, "SVA-based covergroups" yerine "functional-coverage
    monitors" yazild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
2026-09-12 deneme/uvm: 5.052 kapsama ozeti yenilendi - fonksiyonel kapsama 22/22
    main'den tasinan uc duzeltme commit'i (UART STP=3, Berk'in hatalari, eski
    hatalar) bu dalda Verilator 5.052 ile yeniden dogrulandi; dallar
    birlestirilmedi.
    - verif/coverage_summary.txt: 13 Eylul 5.052 kosusu. Fonksiyonel 22/22
    (UART 7/7), auto-clear 6410 kontrol 0 ihlal; satir %90,7 (359/396) ve dal
    %88,5 (818/924) 10 Eylul 5.052 kosusuyla ayni.
    - README 10.8 tarih cumlesi ve coverage_siniflandirma.md (12 Eylul eki, 11.
    bolum) bu dalin 5.052 sayilarina gore.
    Dogrulama (Verilator 5.052, z3 4.8.12):
    - make uvm: 20 PASS, 0 FAIL (rastgele testler 3 tohumla); her cikarimda 1001
    AXI4 yazma sozcugu OK.
    - make arch-test: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
2026-09-28 Add GPLv3 license
    [macro_placement.cfg]
2026-10-05 docs: short landing README, full report moved to docs/DOCUMENTATION.md
2026-10-06 docs: animated board demo in the README
2026-10-06 test: English test output, per-test reports and register access logs
    Every message a test prints is now in English: make help, the Makefiles,
    the scripts, the simulator, the testbenches, the UVM environment and the
    firmware test output. Parsers that read these messages were updated with
    them and still accept the old wording.
    Each simulation now writes two files into its log directory:
    - bus_trace.log: every peripheral register access (cycle, address,
    register name, value) and every check the test made, with a summary
    table at the end. SoC-level simulations get it from a bound monitor
    (verif/sva/soc_bus_trace.sv); block testbenches log through the shared
    package verif/sva/tb_log_pkg.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
